ryanmccormickdev/bassbox/enclosure/renders/enclosure-details.png

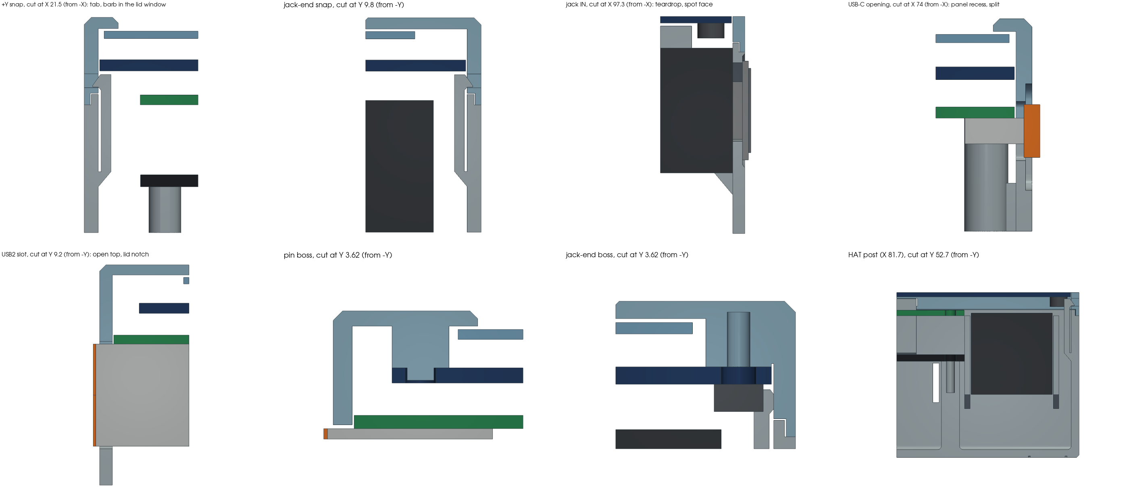
enclosure/renders/enclosure-details.png
