ryanmccormickdev/bassbox/enclosure/renders/section-x.png

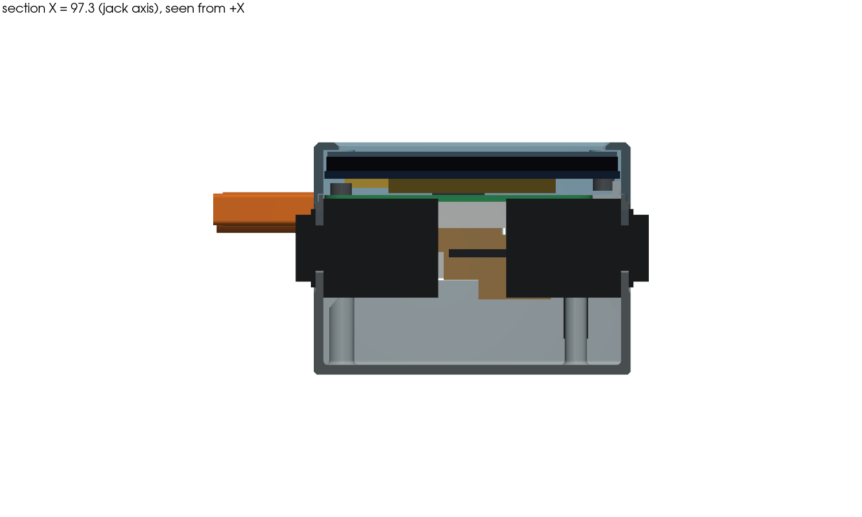
enclosure/renders/section-x.png
