ryanmccormickdev/bassbox/enclosure/renders/section-y.png

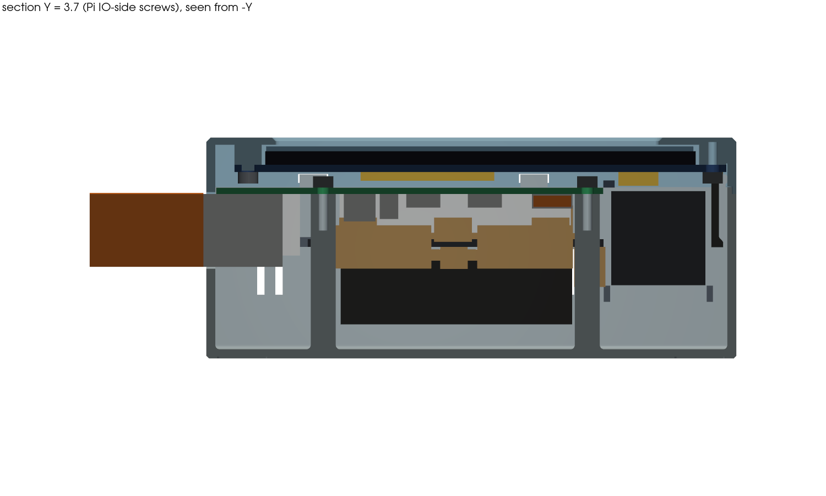
enclosure/renders/section-y.png
