ryanmccormickdev/bassbox/enclosure/renders/section-z.png

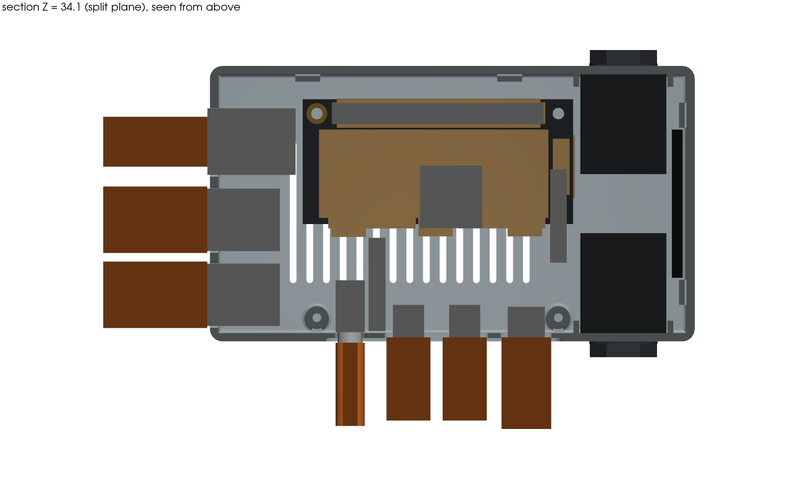
enclosure/renders/section-z.png
