ryanmccormickdev/bassbox/engine/tests/results/plots/drive_spectra_41.png

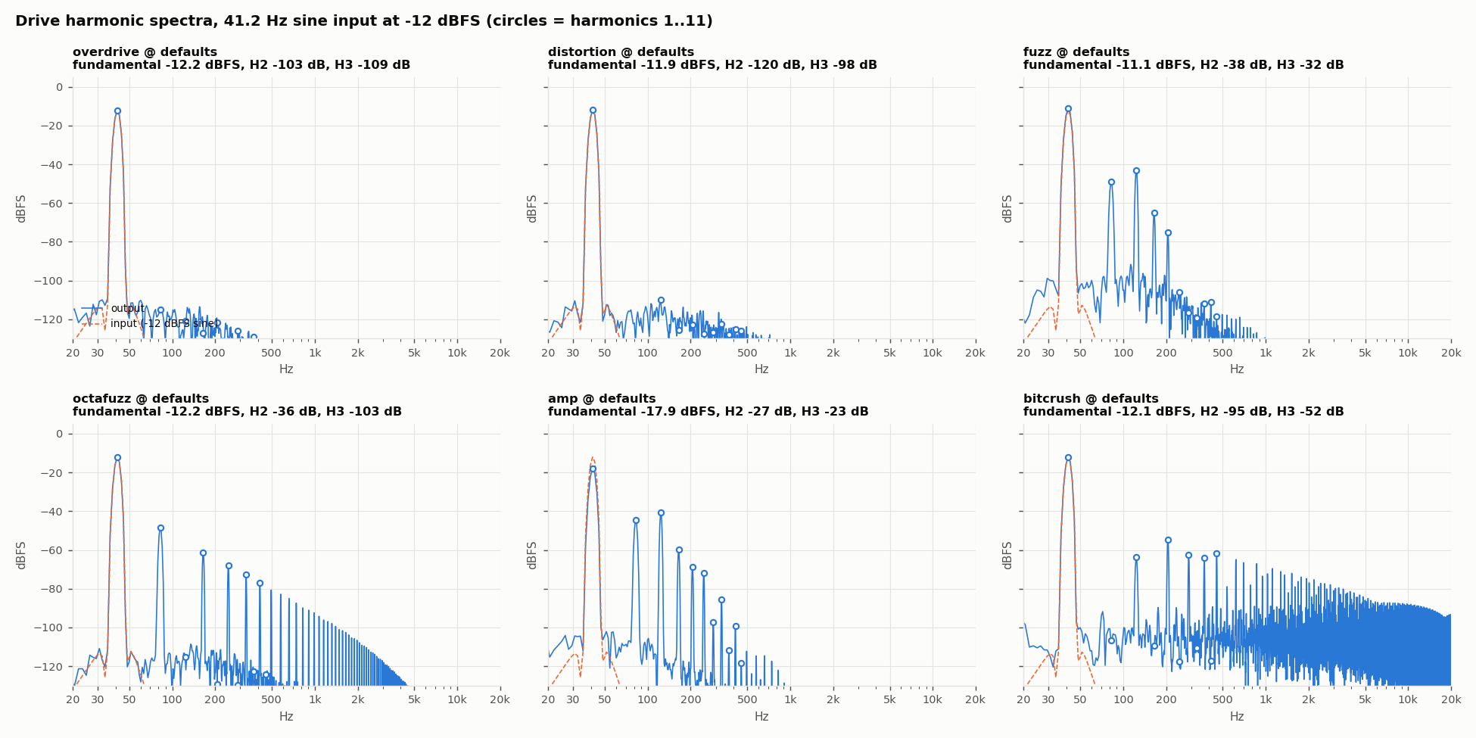
engine/tests/results/plots/drive_spectra_41.png
