ryanmccormickdev/bassbox/engine/tests/results/plots/drive_spectra_110.png

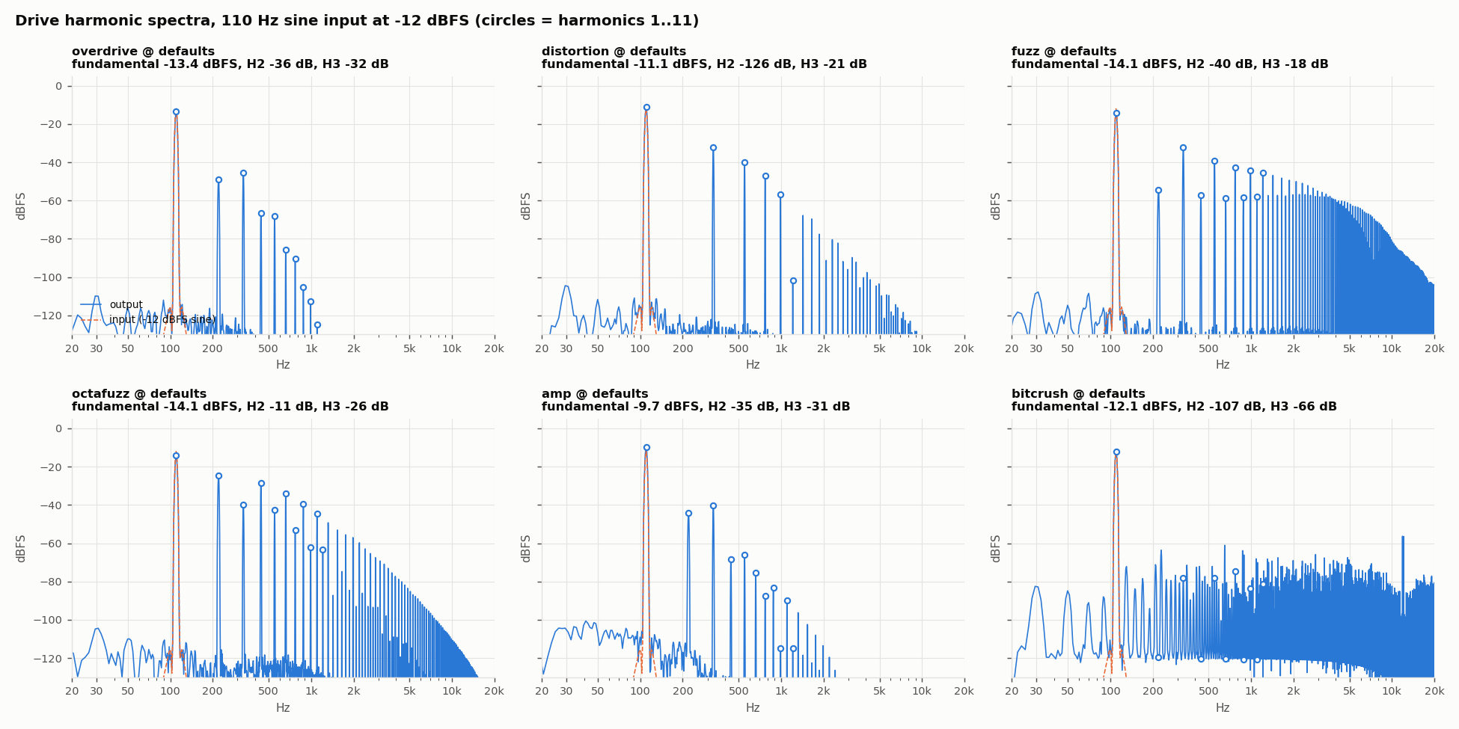
engine/tests/results/plots/drive_spectra_110.png
