ryanmccormickdev/bassbox/ui/mockups/contact_ABC.png

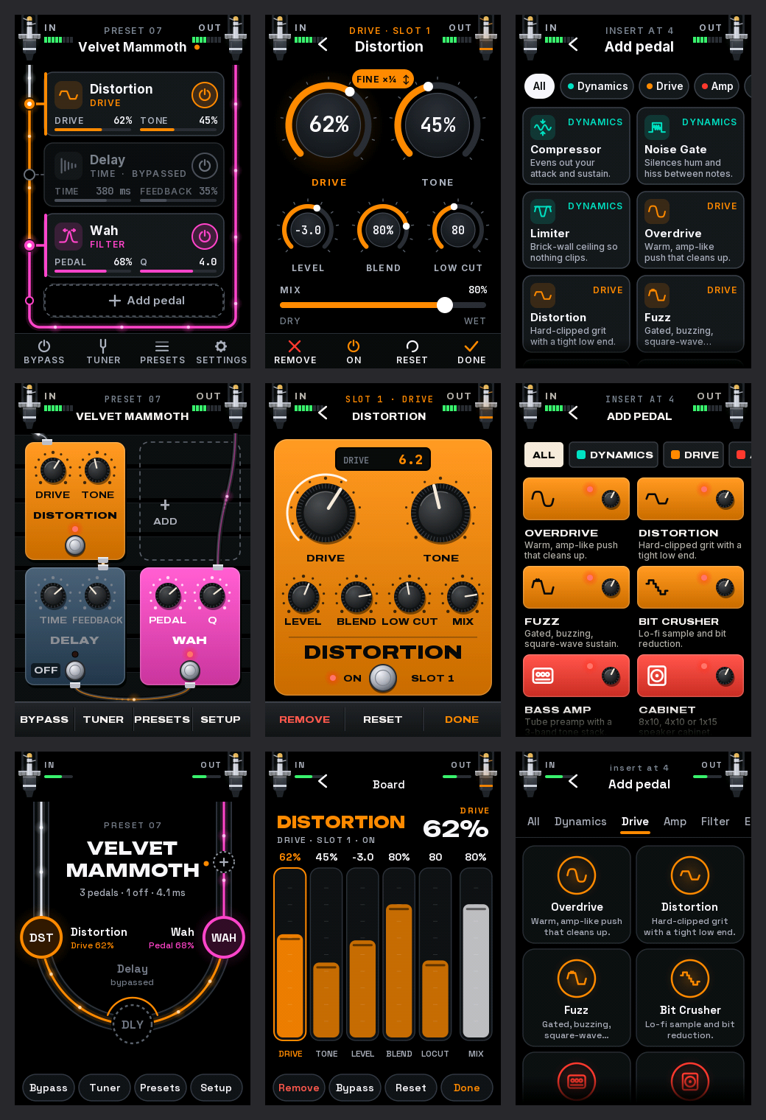
ui/mockups/contact_ABC.png
