ryanmccormickdev/bassbox/ui/mockups/dirA_board.png

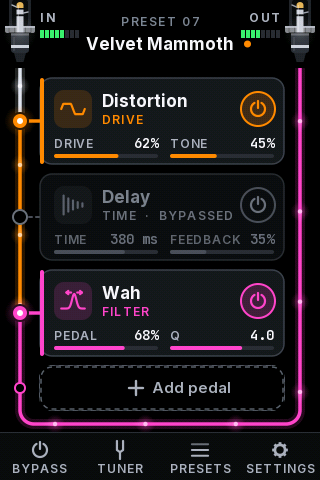
ui/mockups/dirA_board.png
