ryanmccormickdev/bassbox/ui/mockups/dirA_edit.png

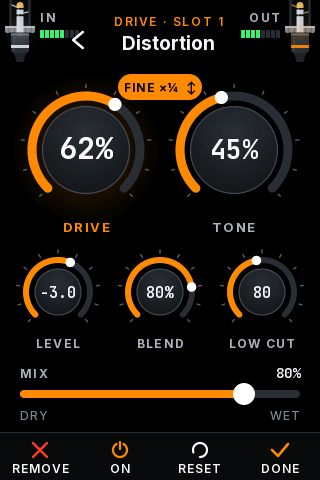
ui/mockups/dirA_edit.png
