ryanmccormickdev/bassbox/ui/mockups/dirA_library.png

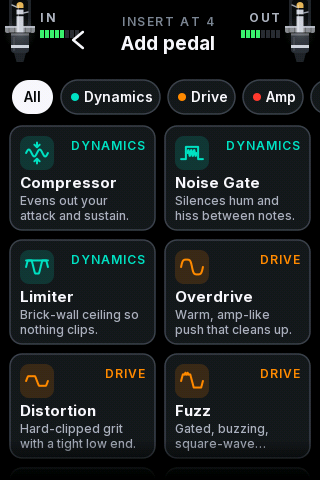
ui/mockups/dirA_library.png
