ryanmccormickdev/bassbox/ui/mockups/dirB_board.png

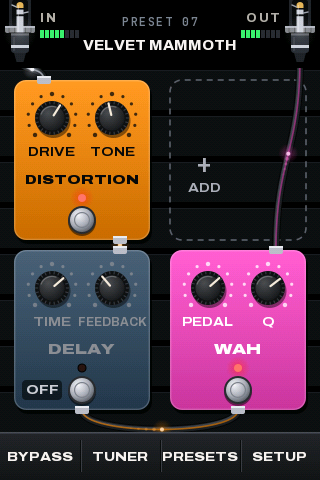
ui/mockups/dirB_board.png
