ryanmccormickdev/bassbox/ui/mockups/dirB_edit.png

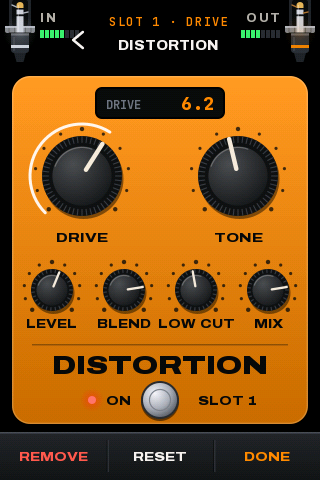
ui/mockups/dirB_edit.png
