ryanmccormickdev/bassbox/ui/mockups/dirB_library.png

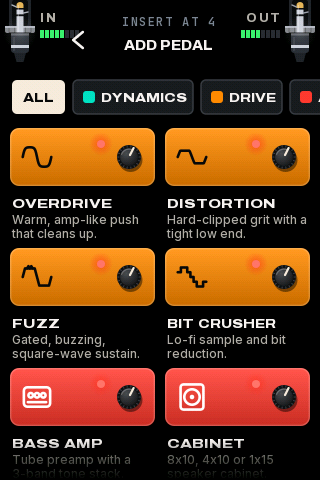
ui/mockups/dirB_library.png
