ryanmccormickdev/bassbox/ui/mockups/dirC_board.png

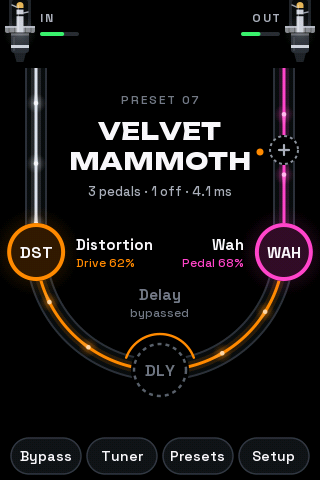
ui/mockups/dirC_board.png
