ryanmccormickdev/bassbox/ui/mockups/dirC_edit.png

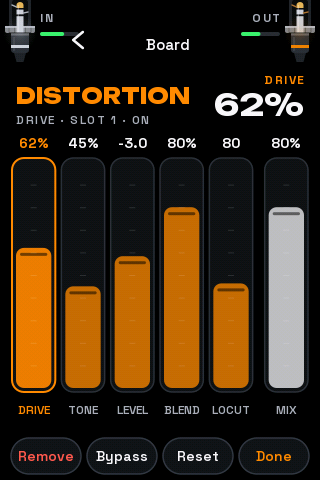
ui/mockups/dirC_edit.png
