ryanmccormickdev/bassbox/ui/mockups/dirC_library.png

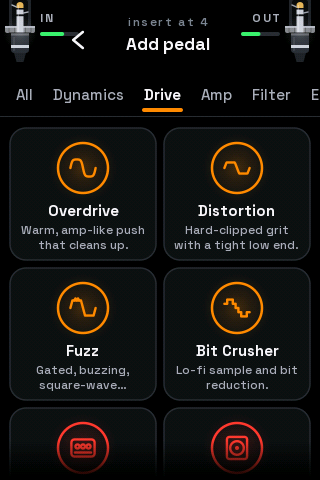
ui/mockups/dirC_library.png
