ryanmccormickdev/bassbox/ui/mockups/photo_dirA_board.jpg

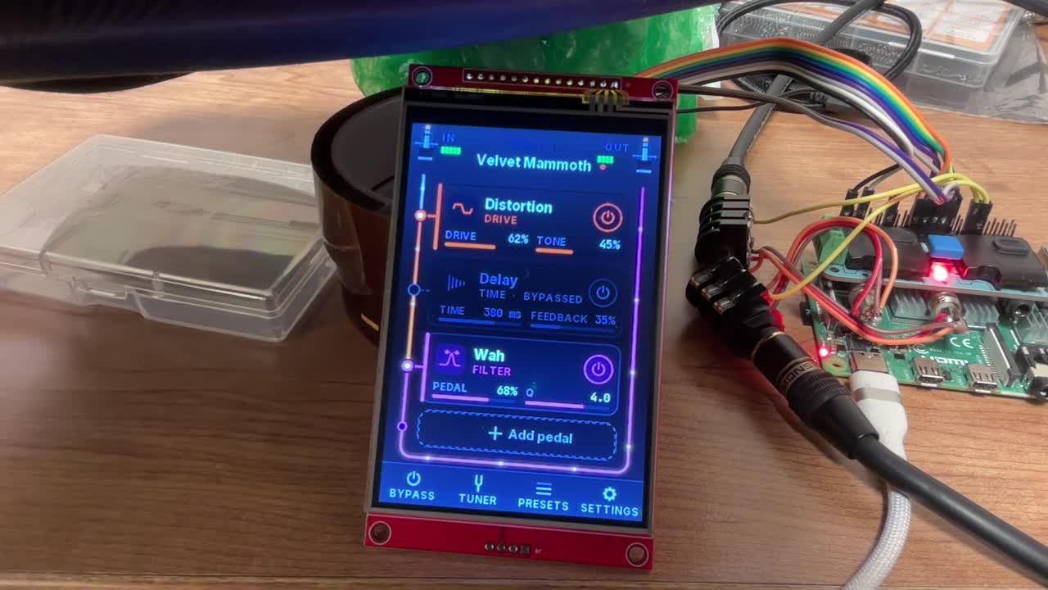
ui/mockups/photo_dirA_board.jpg
