ryanmccormickdev/bassbox/ui/mockups/photo_dirB_board.jpg

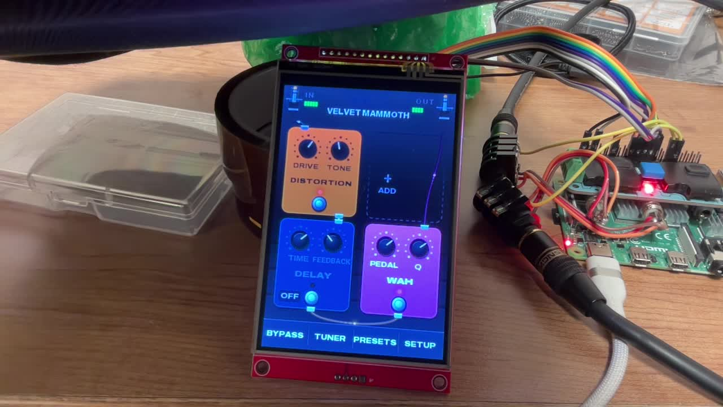
ui/mockups/photo_dirB_board.jpg
