ryanmccormickdev/bassbox/ui/shots/audiocheck.png

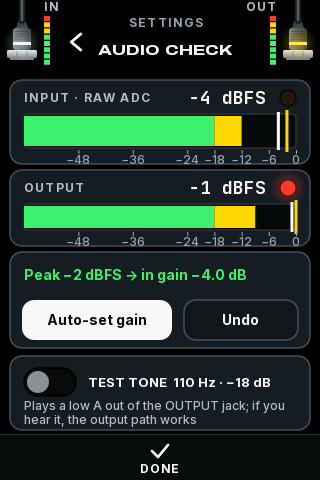
ui/shots/audiocheck.png
