ryanmccormickdev/bassbox/ui/shots/audiocheck_listen.png

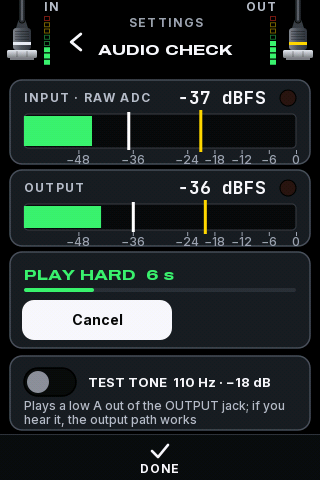
ui/shots/audiocheck_listen.png
