ryanmccormickdev/bassbox/ui/shots/audiocheck_pair.png

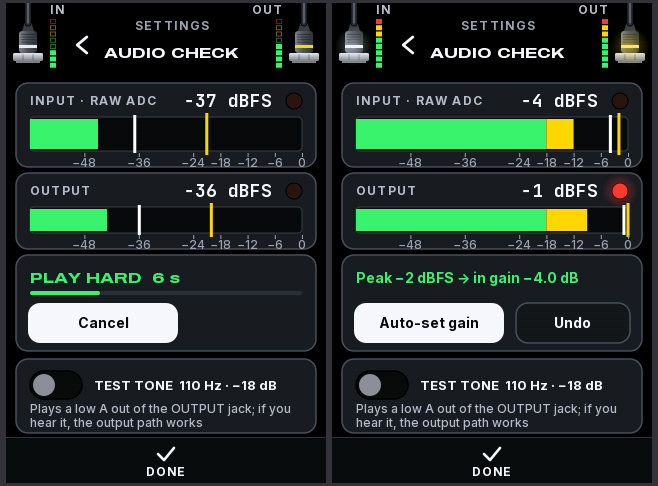
ui/shots/audiocheck_pair.png
