ryanmccormickdev/bassbox/ui/shots/audiocheck_pi.png

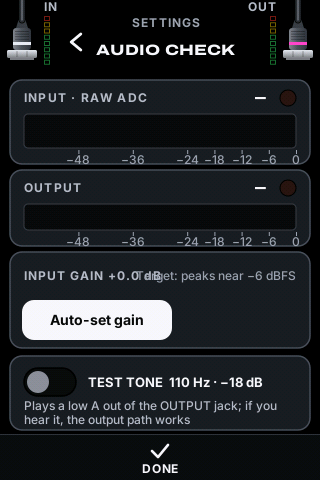
ui/shots/audiocheck_pi.png
