ryanmccormickdev/bassbox/ui/shots/board_3.png

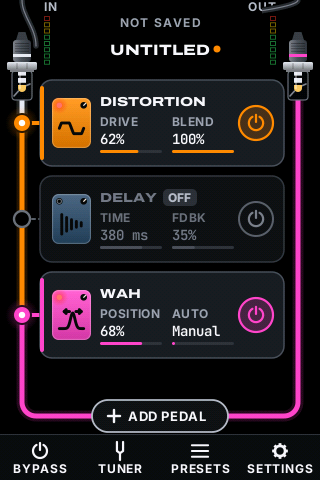
ui/shots/board_3.png
