ryanmccormickdev/bassbox/ui/shots/board_7.png

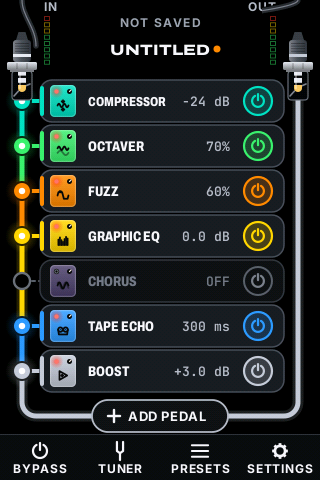
ui/shots/board_7.png
