ryanmccormickdev/bassbox/ui/shots/board_bypass.png

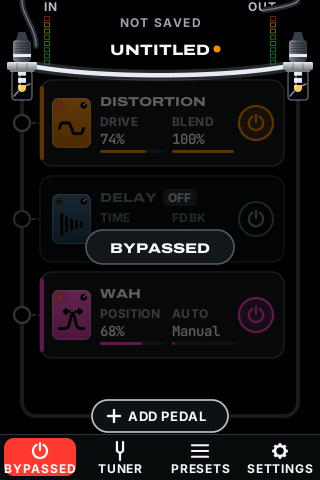
ui/shots/board_bypass.png
