ryanmccormickdev/bassbox/ui/shots/board_in_unplugged.png

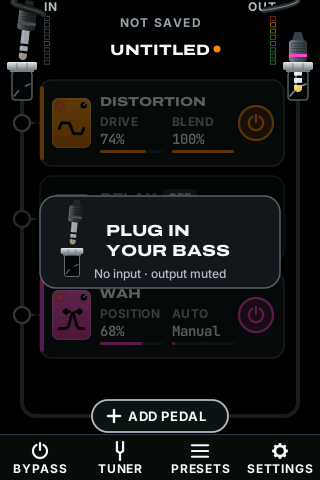
ui/shots/board_in_unplugged.png
