ryanmccormickdev/bassbox/ui/shots/contact.png

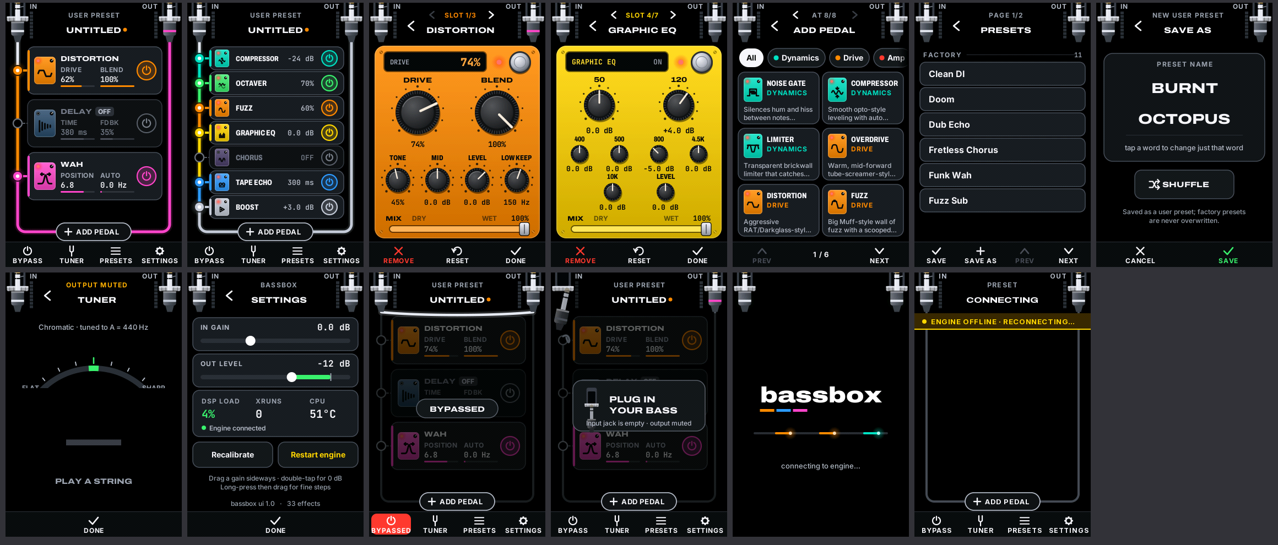
ui/shots/contact.png
