ryanmccormickdev/bassbox/ui/shots/edit_distortion.png

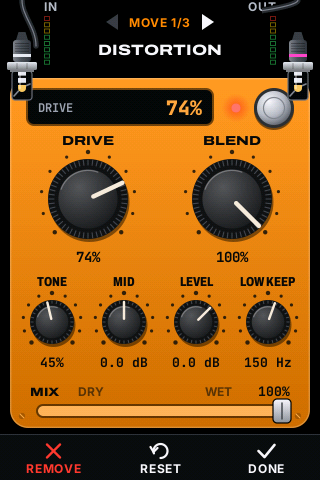
ui/shots/edit_distortion.png
