ryanmccormickdev/bassbox/ui/shots/edit_geq7.png

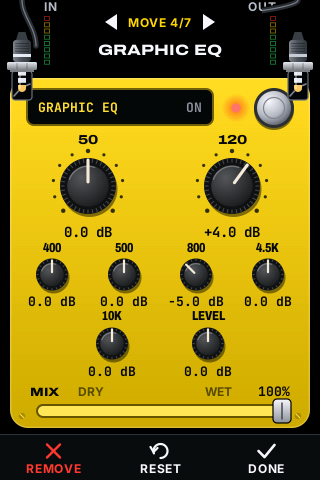
ui/shots/edit_geq7.png
