ryanmccormickdev/bassbox/ui/shots/edit_looper.png

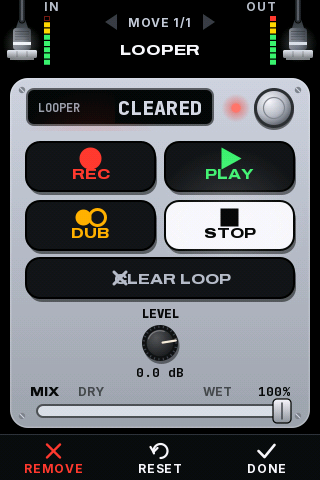
ui/shots/edit_looper.png
