ryanmccormickdev/bassbox/ui/shots/edit_nam.png

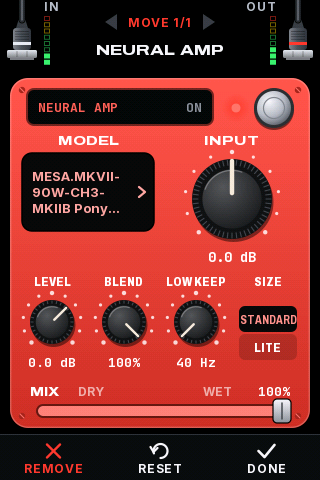
ui/shots/edit_nam.png
