ryanmccormickdev/bassbox/ui/shots/jack_anim.png

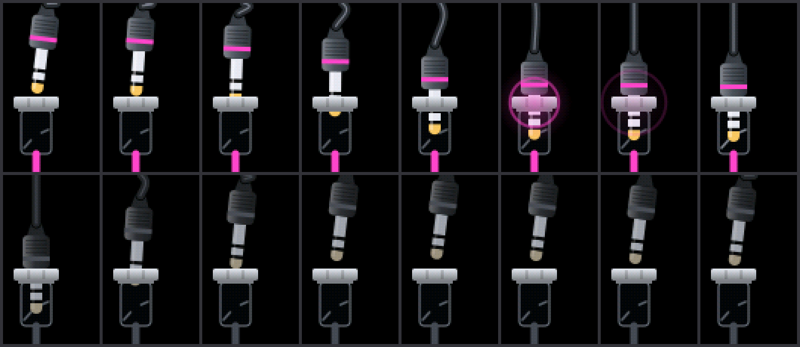
ui/shots/jack_anim.png
