ryanmccormickdev/bassbox/ui/shots/library.png

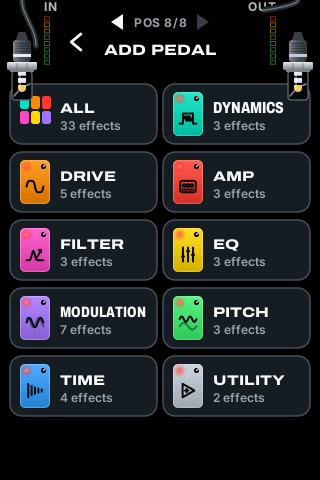
ui/shots/library.png
