ryanmccormickdev/bassbox/ui/shots/library_drive.png

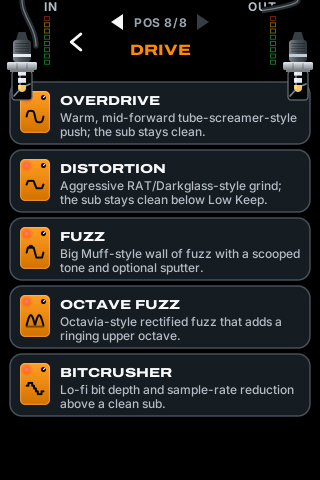
ui/shots/library_drive.png
