ryanmccormickdev/bassbox/ui/shots/nam_picker.png

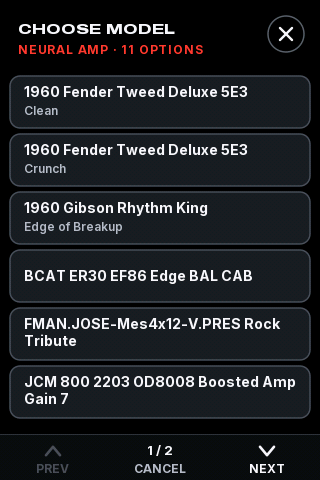
ui/shots/nam_picker.png
