ryanmccormickdev/bassbox/ui/shots/nam_presets.png

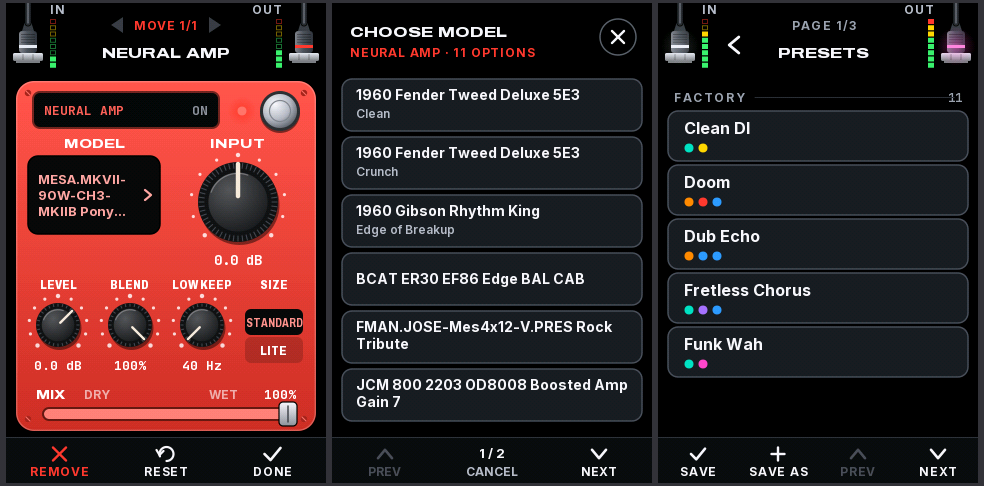
ui/shots/nam_presets.png
