ryanmccormickdev/bassbox/ui/shots/phaseC.png

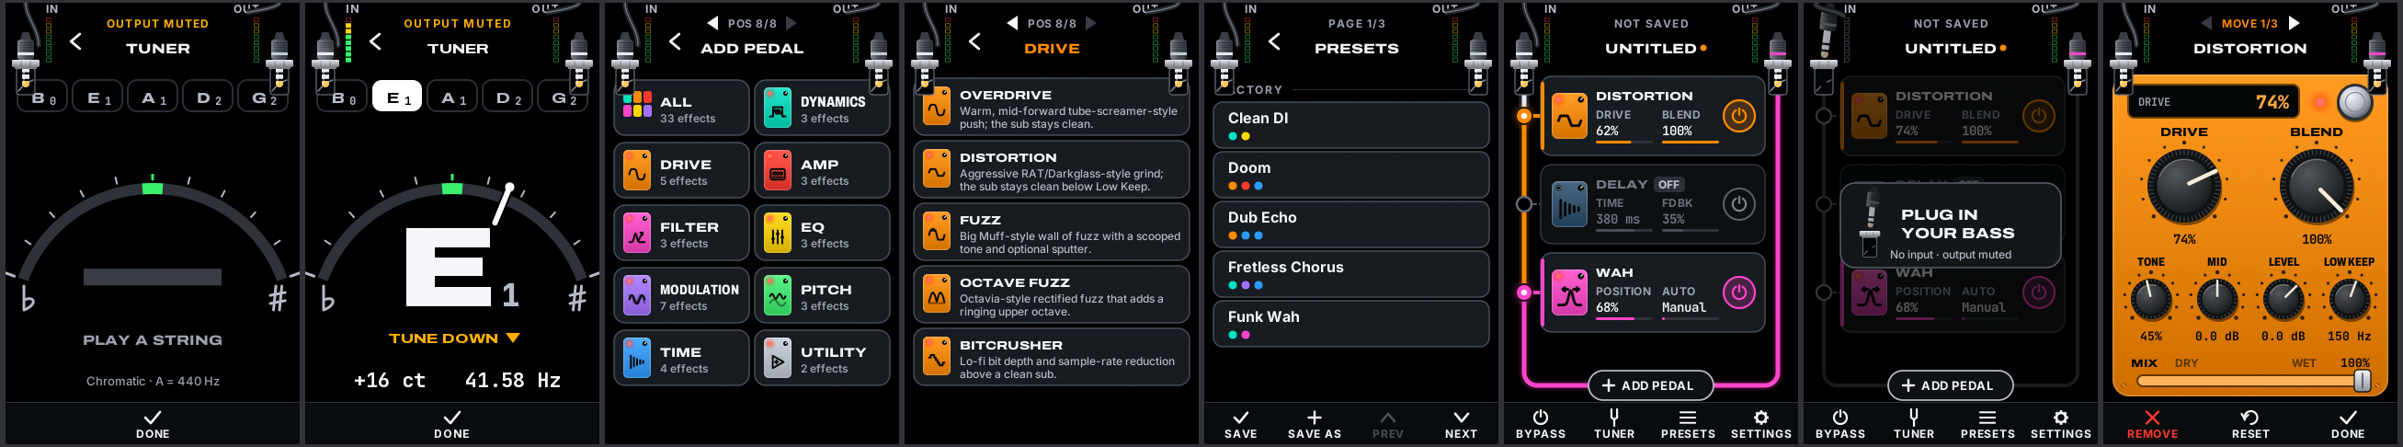
ui/shots/phaseC.png
