ryanmccormickdev/bassbox/ui/shots/presets.png

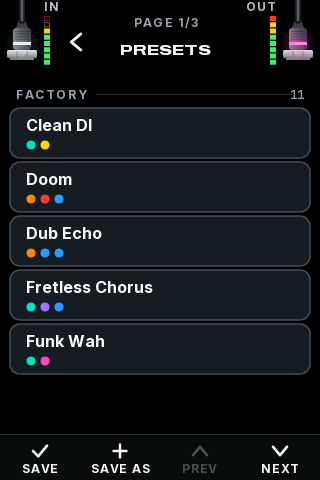
ui/shots/presets.png
