ryanmccormickdev/bassbox/ui/shots/reconnecting.png

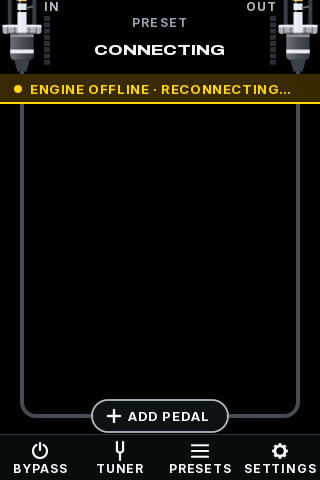
ui/shots/reconnecting.png
