ryanmccormickdev/bassbox/ui/shots/saveas.png

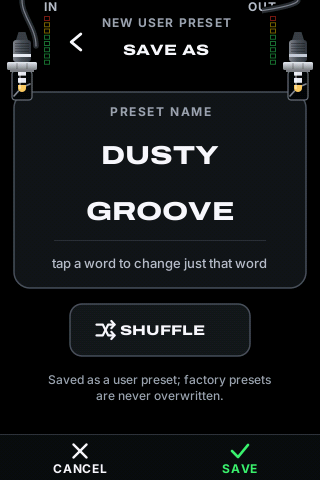
ui/shots/saveas.png
