ryanmccormickdev/bassbox/ui/shots/settings.png

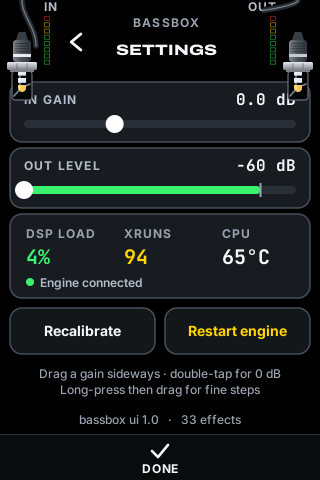
ui/shots/settings.png
