ryanmccormickdev/bassbox/ui/shots/sweep_boards.png

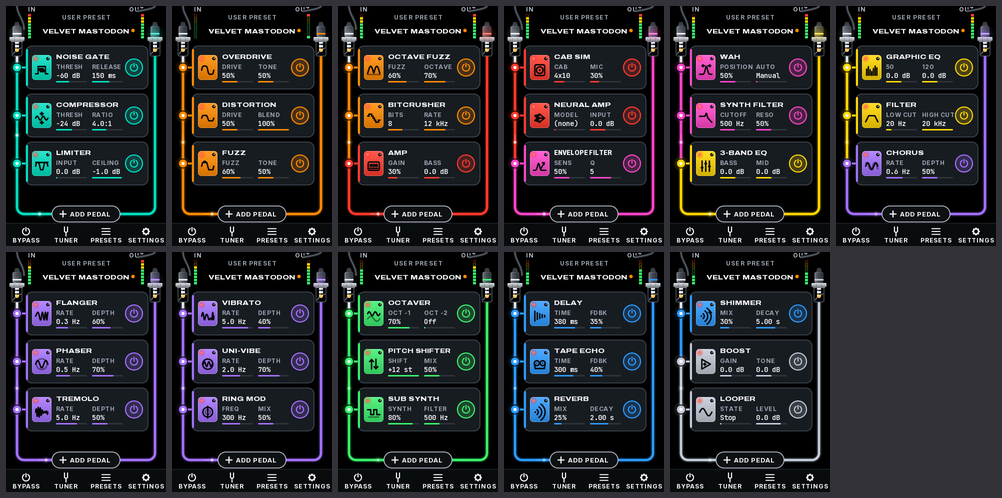
ui/shots/sweep_boards.png
