ryanmccormickdev/bassbox/ui/shots/sweep_faces.png

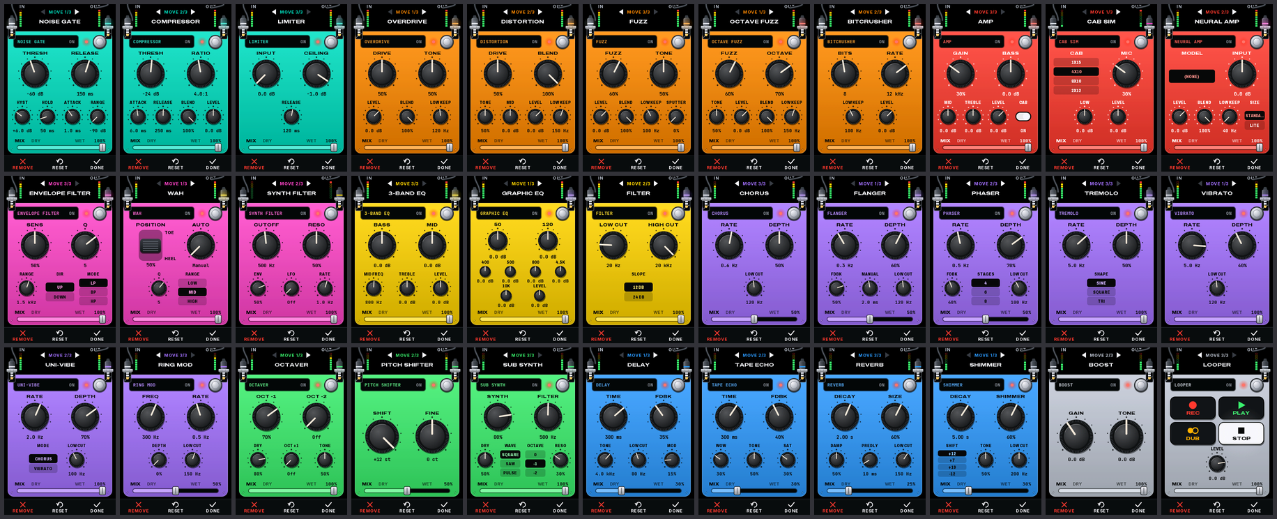
ui/shots/sweep_faces.png
