ryanmccormickdev/bassbox/ui/shots/tuner.png

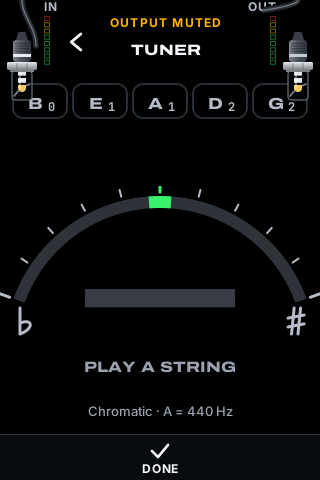
ui/shots/tuner.png
