ryanmccormickdev/bassbox/ui/shots/tuner_reading_mock.png

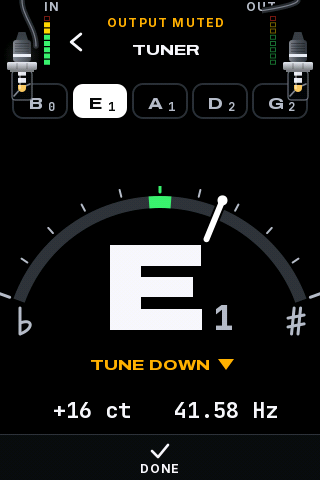
ui/shots/tuner_reading_mock.png
