ryanmccormickdev/bassbox/enclosure/renders/components-keepouts.png

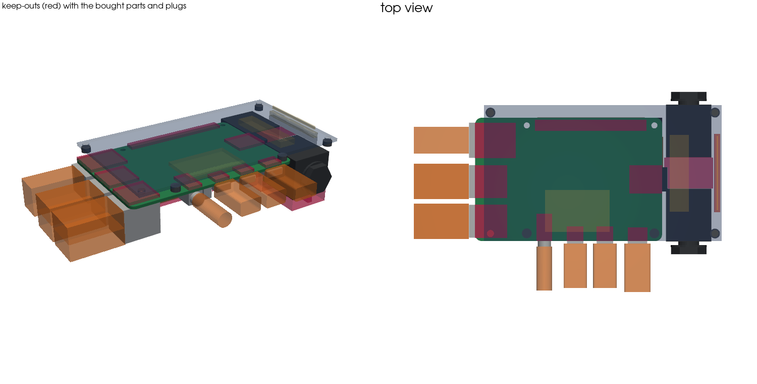
enclosure/renders/components-keepouts.png
