ryanmccormickdev/bassbox/enclosure/exports/step/pedal-assembly.step

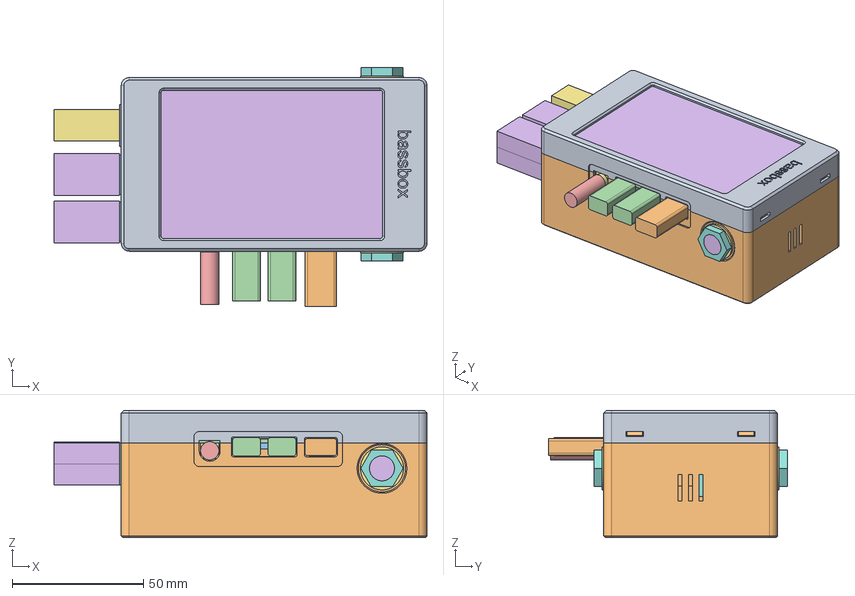
[picture p51: CAD file, 2026-11-01]
enclosure/exports/step/pedal-assembly.step
142.0 x 90.9 x 48.5 mm
lid
base
spacer
lcd.pcb
lcd.panel
lcd.glass
lcd.header
lcd.dupont
lcd.tails
lcd.smd
lcd.sd
pi.pcb
pi.usb_c
pi.hdmi0
pi.hdmi1
pi.audio
pi.usb2
pi.usb3
pi.eth
pi.header
pi.soc
pi.csi
pi.dsi
pi.sd_card
hat.pcb
hat.terminal
hat.terminal_tails
hat.speaker_a
hat.speaker_b
hat.jack35_a
hat.jack35_b
hat.jack35_c
hat.button
hat.header_plastic
hat.pins
hat.female
hat.bottom_smd
hat.bottom_pins
hat.smd_hole_a
hat.smd_hole_b
hat.dupont
jack_in.body
jack_in.bushing
jack_in.washer
jack_in.nut
jack_out.body
jack_out.bushing
jack_out.washer
jack_out.nut
screw.pi_io1
screw.pi_io2
screw.lcd1
screw.lcd2
screw.lcd3
plug.usb_c.overmold
plug.usb_c.metal
plug.hdmi0.overmold
plug.hdmi1.overmold
plug.audio.overmold
plug.usb2a.overmold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
