ryanmccormickdev/bassbox/enclosure/exports/3mf/pedal-plate.3mf

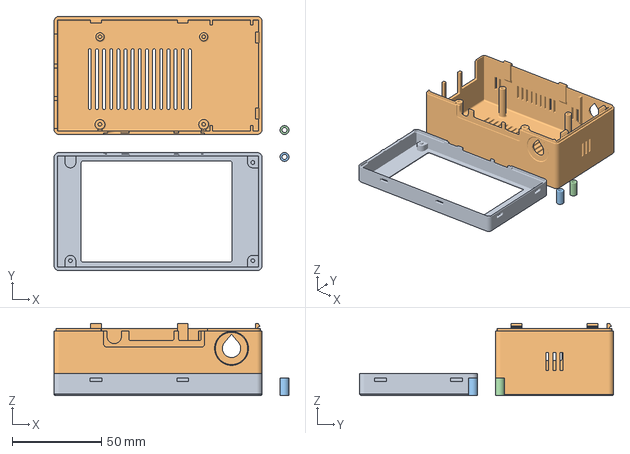
[picture p52: CAD file, 2026-11-01]
enclosure/exports/3mf/pedal-plate.3mf
131.4 x 142.3 x 40.4 mm
