ryanmccormickdev/bassbox/enclosure/exports/stl/spacer.stl

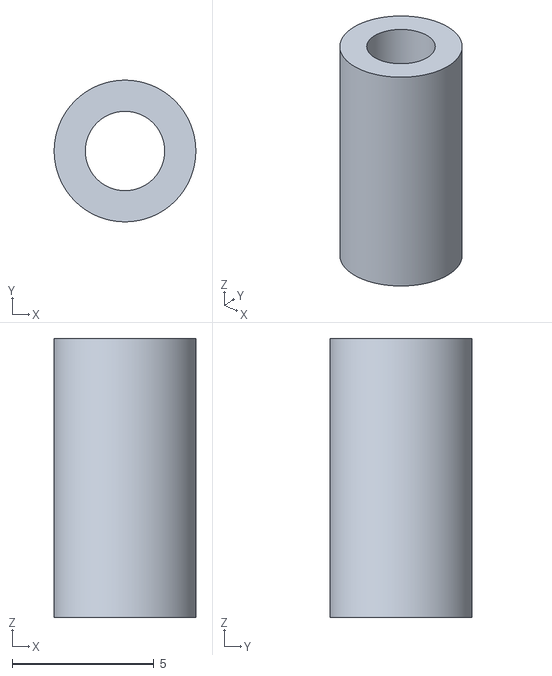
[picture p53: CAD file, 2026-11-01]
enclosure/exports/stl/spacer.stl
5.00 x 5.00 x 9.85
