ryanmccormickdev/bassbox/enclosure/print-profiles/prusa-mk39s/pedal-base-mk39s-clear-petg.3mf

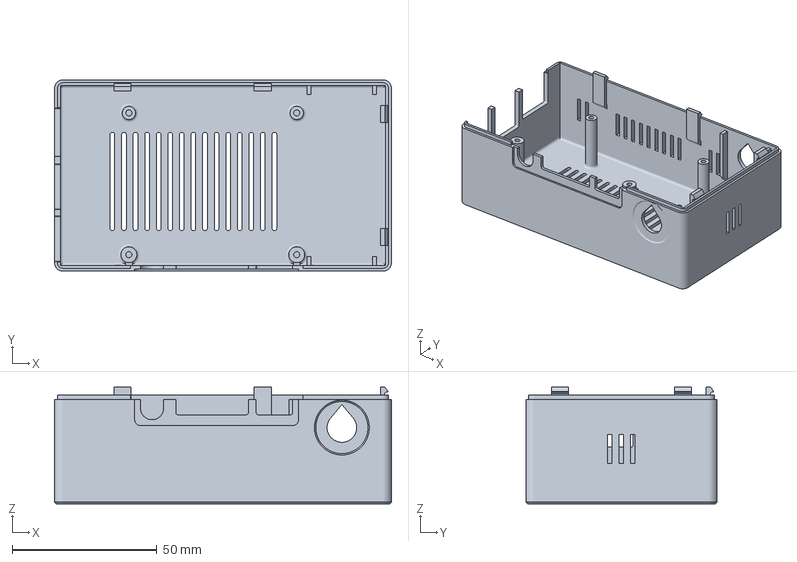
[picture p54: CAD file, 2026-11-01]
enclosure/print-profiles/prusa-mk39s/pedal-base-mk39s-clear-petg.3mf
116.4 x 66.1 x 40.4 mm
