ryanmccormickdev/bassbox/enclosure/exports/step/enclosure-installed.step

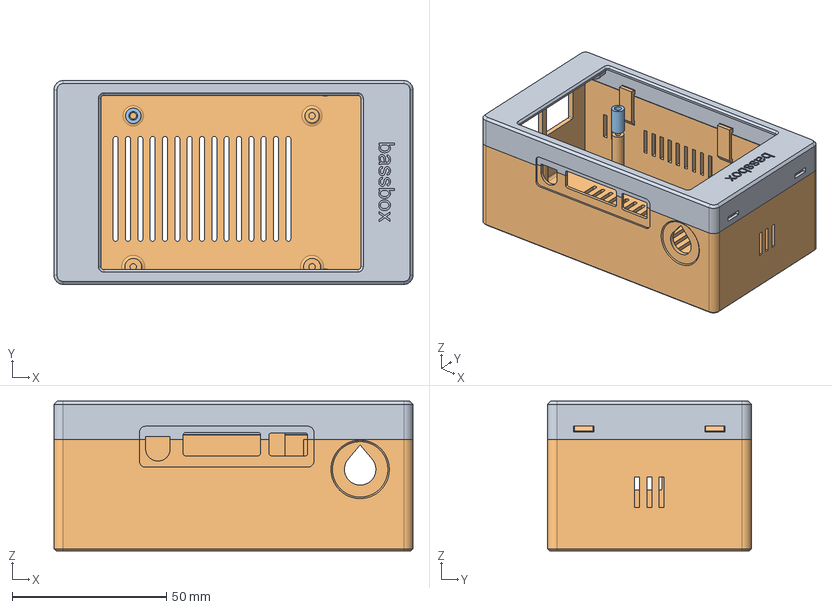
[picture p55: CAD file, 2026-11-01]
enclosure/exports/step/enclosure-installed.step
116.4 x 66.1 x 48.5 mm
lid
base
spacer
