ryanmccormickdev/bassbox/enclosure/exports/stl/lid.stl

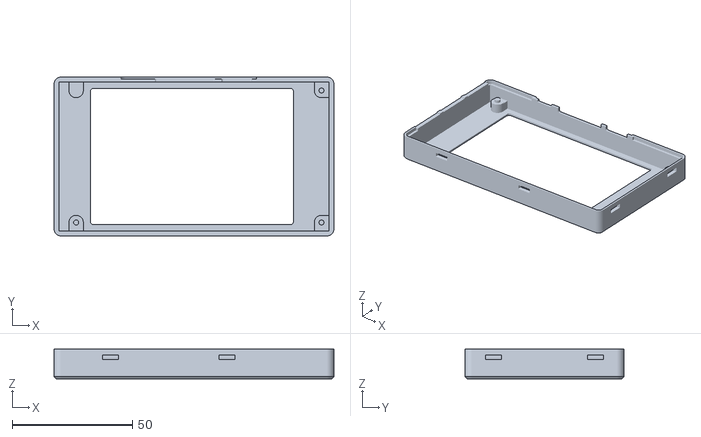
[picture p56: CAD file, 2026-11-01]
enclosure/exports/stl/lid.stl
116.4 x 66.1 x 12.4
