ryanmccormickdev/bassbox/(list of files, cad)

Other CAD files:
enclosure/print-profiles/prusa-xl/pedal-plate-xl-clear-petg.3mf
enclosure/exports/stl/base.stl
