ryanmccormickdev/bassbox/enclosure/renders/assembly-exploded.png

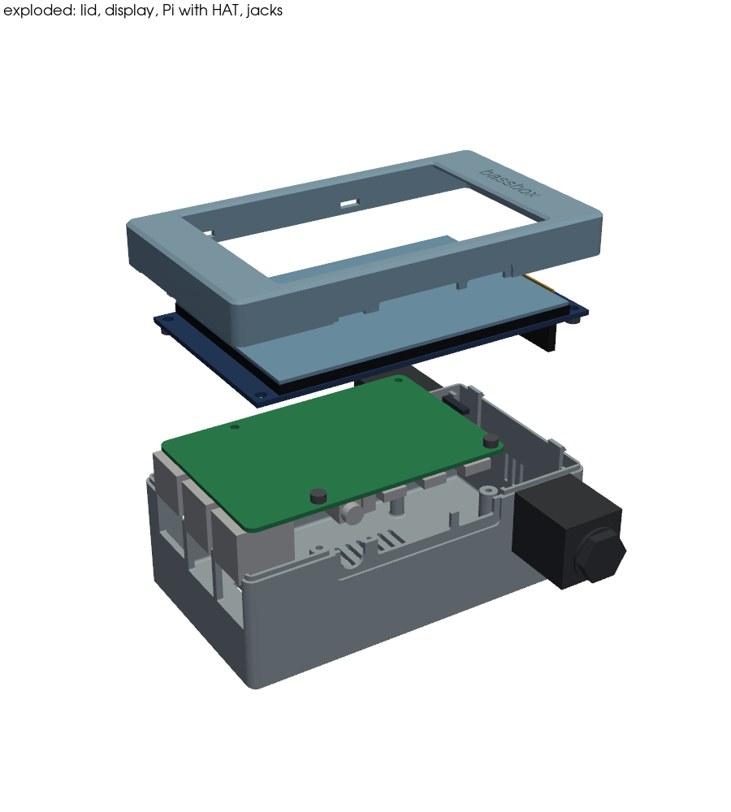
enclosure/renders/assembly-exploded.png
