ryanmccormickdev/bassbox/enclosure/renders/assembly-iso.png

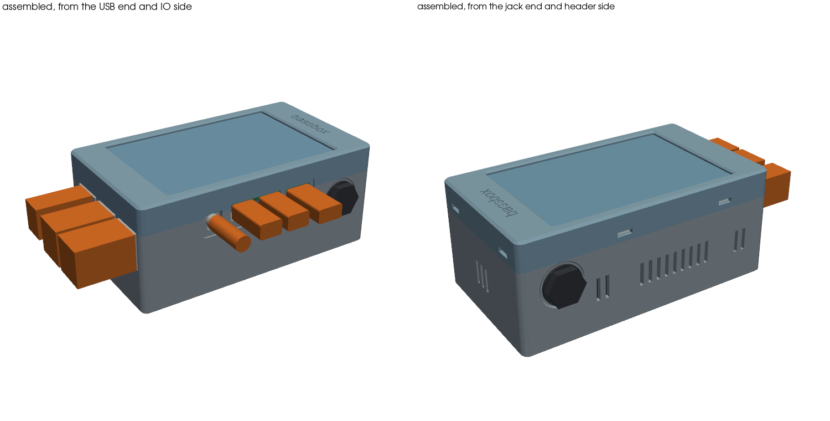
enclosure/renders/assembly-iso.png
