ryanmccormickdev/bassbox/enclosure/renders/assembly-translucent.png

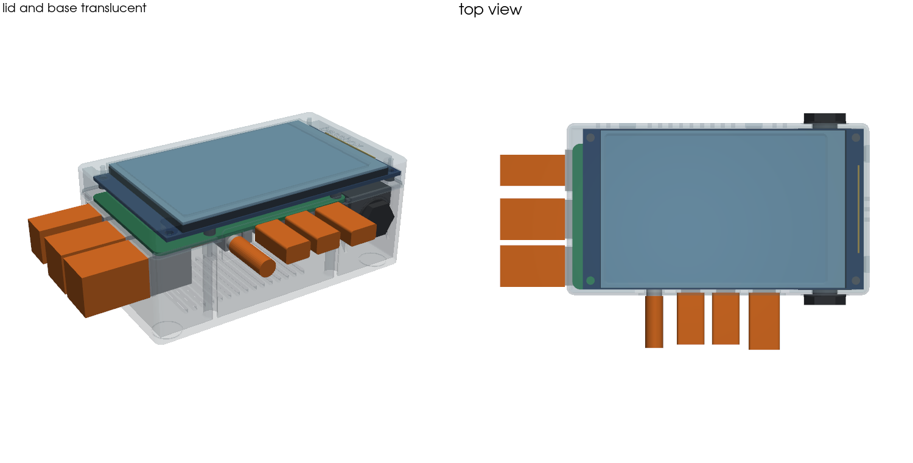
enclosure/renders/assembly-translucent.png
