ryanmccormickdev/bassbox/enclosure/renders/base-installed.png

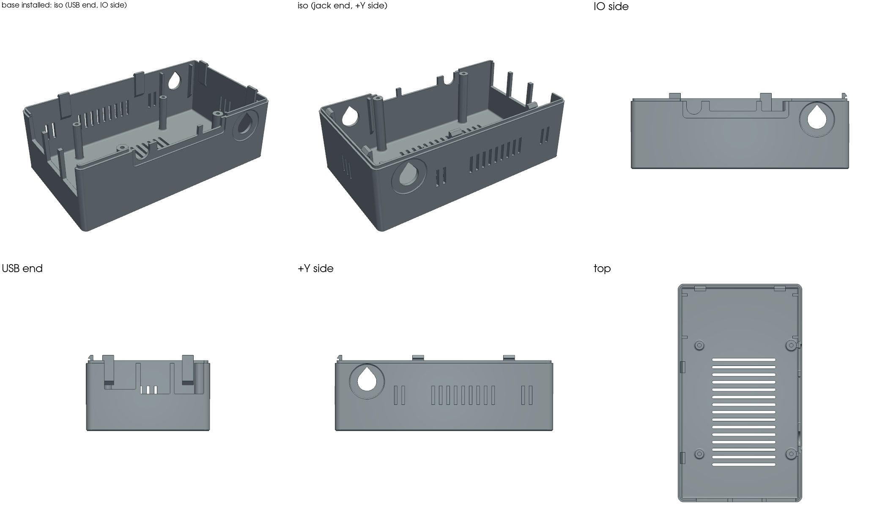
enclosure/renders/base-installed.png
