ryanmccormickdev/bassbox/enclosure/renders/base-print.png

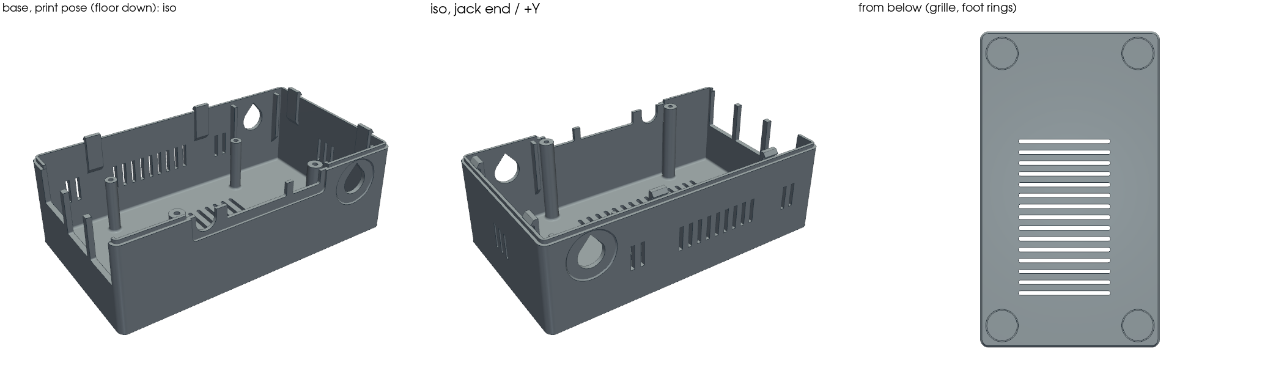
enclosure/renders/base-print.png
