ryanmccormickdev/bassbox/enclosure/renders/enclosure-installed.png

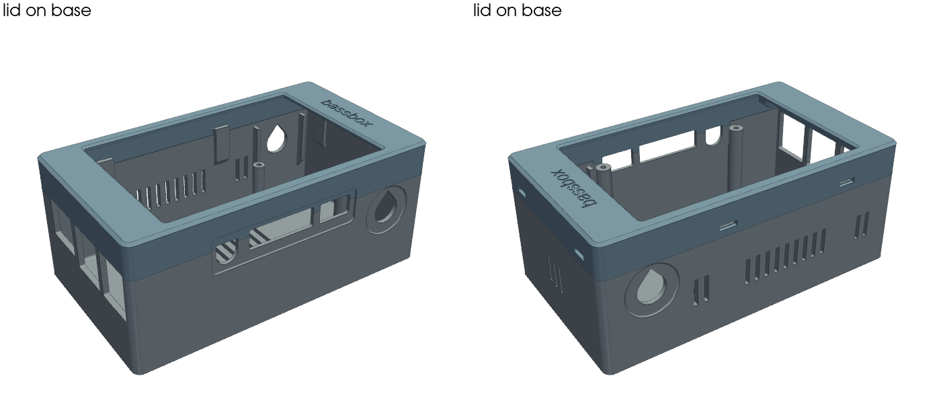
enclosure/renders/enclosure-installed.png
