ryanmccormickdev/bassbox/enclosure/renders/lid-installed.png

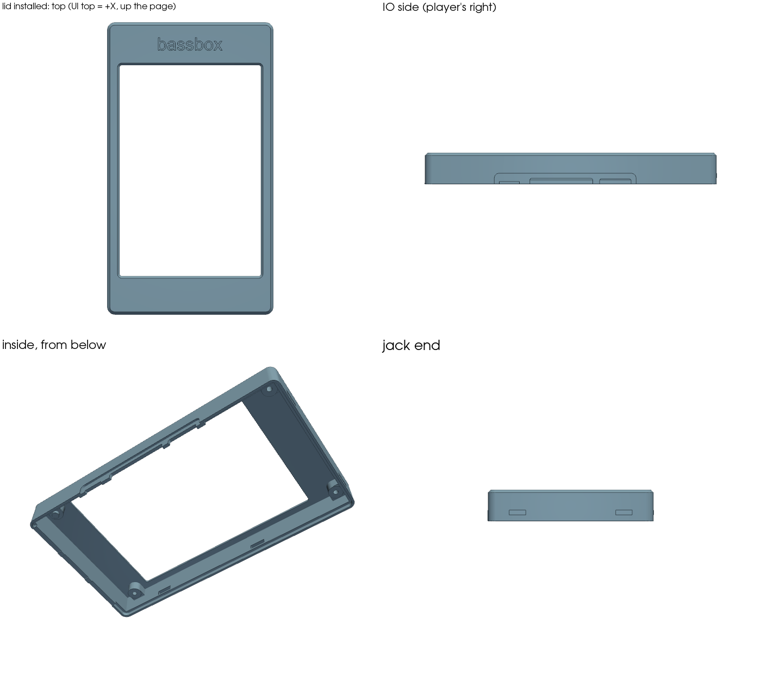
enclosure/renders/lid-installed.png
