ryanmccormickdev/bassbox/enclosure/renders/lid-print.png

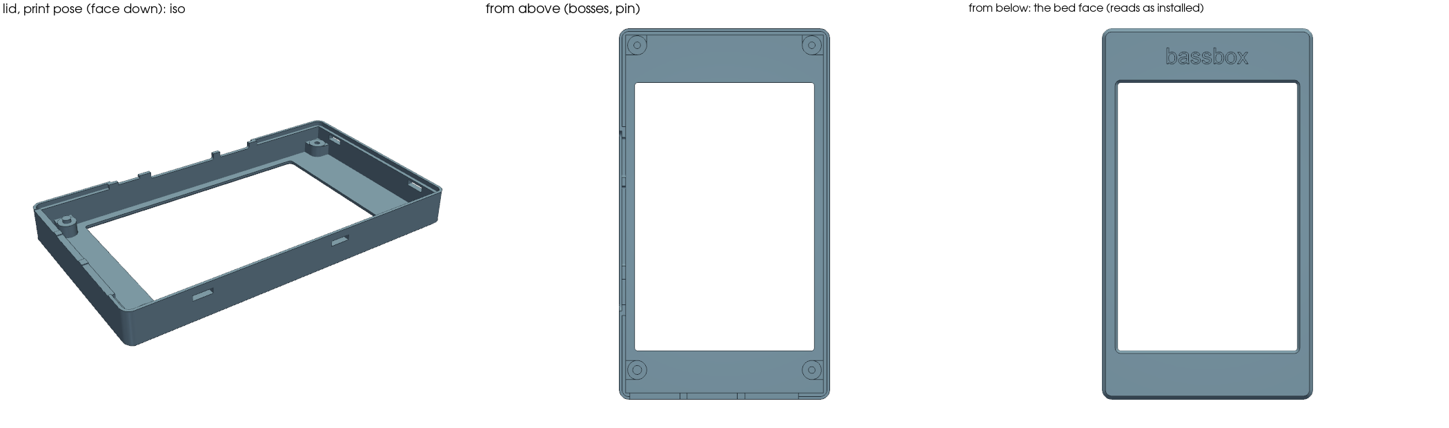
enclosure/renders/lid-print.png
