ryanmccormickdev/bassbox/enclosure/renders/spacer-print.png

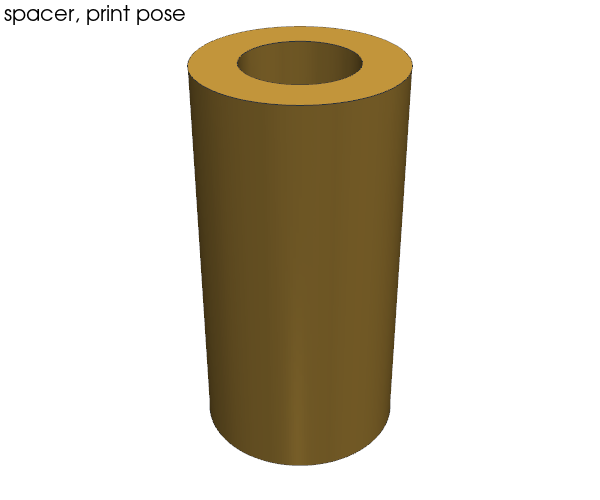
enclosure/renders/spacer-print.png
