ryanmccormickdev/bassbox/engine/tests/results/cpu.md

# CPU per 64-frame block on bassbox

Mean and p99 microseconds per 64-frame block (1333 us of audio); % = mean / period, i.e. share of one core. Worst of defaults and all-max settings. FTZ on.

| id | mean us (defaults) | mean us (all-max) | p99 us | % of core |
|---|---|---|---|---|
| gate | 1.94 | 1.85 | 1.89 | 0.15% |
| comp | 5.35 | 5.00 | 5.68 | 0.40% |
| limiter | 11.91 | 12.54 | 13.04 | 0.94% |
| overdrive | 16.84 | 15.45 | 16.85 | 1.26% |
| distortion | 14.10 | 14.03 | 14.33 | 1.06% |
| fuzz | 18.26 | 22.58 | 23.33 | 1.69% |
| octafuzz | 16.41 | 16.33 | 16.50 | 1.23% |
| bitcrush | 2.91 | 3.05 | 3.07 | 0.23% |
| amp | 29.98 | 26.56 | 30.76 | 2.25% |
| cab | 4.02 | 4.02 | 4.04 | 0.30% |
| nam | 275.62 | 132.38 | 359.31 | 20.67% |
| env_filter | 11.51 | 11.48 | 11.52 | 0.86% |
| wah | 8.14 | 8.16 | 8.20 | 0.61% |
| synth_filter | 10.78 | 10.78 | 10.83 | 0.81% |
| eq3 | 1.45 | 1.45 | 1.48 | 0.11% |
| geq7 | 0.90 | 3.11 | 3.11 | 0.23% |
| cut | 2.87 | 2.88 | 2.89 | 0.22% |
| chorus | 9.58 | 9.58 | 9.59 | 0.72% |
| flanger | 7.66 | 7.05 | 7.67 | 0.57% |
| phaser | 12.99 | 12.29 | 13.06 | 0.97% |
| tremolo | 2.50 | 2.26 | 2.50 | 0.19% |
| vibrato | 5.07 | 5.08 | 5.09 | 0.38% |
| univibe | 11.06 | 10.35 | 10.37 | 0.83% |
| ringmod | 8.19 | 9.16 | 8.31 | 0.69% |
| octaver | 5.81 | 5.81 | 5.96 | 0.44% |
| pitch | 6.51 | 6.55 | 7.61 | 0.49% |
| subsynth | 16.86 | 16.92 | 17.70 | 1.27% |
| delay | 7.07 | 7.16 | 7.37 | 0.54% |
| tape | 9.27 | 9.28 | 9.54 | 0.70% |
| reverb | 23.44 | 25.02 | 27.76 | 1.88% |
| shimmer | 27.11 | 27.96 | 30.18 | 2.10% |
| boost | 1.10 | 1.09 | 1.11 | 0.08% |
| looper | 0.42 | 0.42 | 0.43 | 0.03% |
