ryanmccormickdev/bassbox/engine/tests/results/presets.md

# Factory presets through the riff (host semantics: enabled, mix, master gains)

| preset | chain | RMS out - in (dB) | peak dBFS | tail after riff (dBFS peak, last 0.5 s of 3 s) | problems |
|---|---|---|---|---|---|
| Clean DI | comp > eq3 | +0.2 | -3.4 | -240 | - |
| Doom | fuzz > amp > reverb | +0.3 | -9.2 | -85 | - |
| Dub Echo | distortion > tape > reverb | +0.3 | -6.6 | -78 | - |
| Fretless Chorus | comp > chorus > reverb | +0.2 | -2.9 | -158 | - |
| Funk Wah | comp > env_filter | -0.1 | -0.6 | -240 | - |
| Fuzz Sub | octaver > fuzz | +0.2 | -7.9 | -240 | - |
| Grit | comp > overdrive > cab | +0.1 | -7.0 | -240 | - |
| Modern Grind | comp > distortion > geq7 > cab | +0.0 | -6.3 | -240 | - |
| Motown | comp > amp > cut | +0.1 | -6.1 | -240 | - |
| Night Drive | distortion > delay > wah | -0.1 | -6.6 | -120 | - |
| Synth Bass | subsynth > synth_filter | -1.2 | -2.0 | -240 | - |
