ryanmccormickdev/bassbox/engine/tests/results/plots/amp_filters_defaults.png

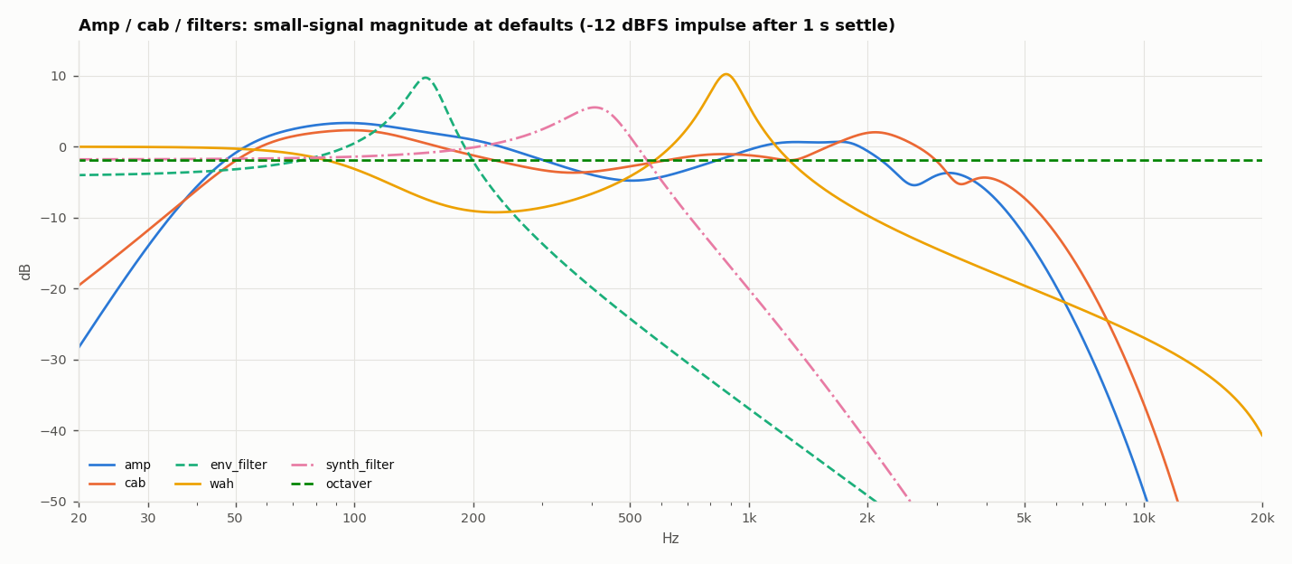
engine/tests/results/plots/amp_filters_defaults.png
