ryanmccormickdev/bassbox/engine/tests/results/plots/cab_responses.png

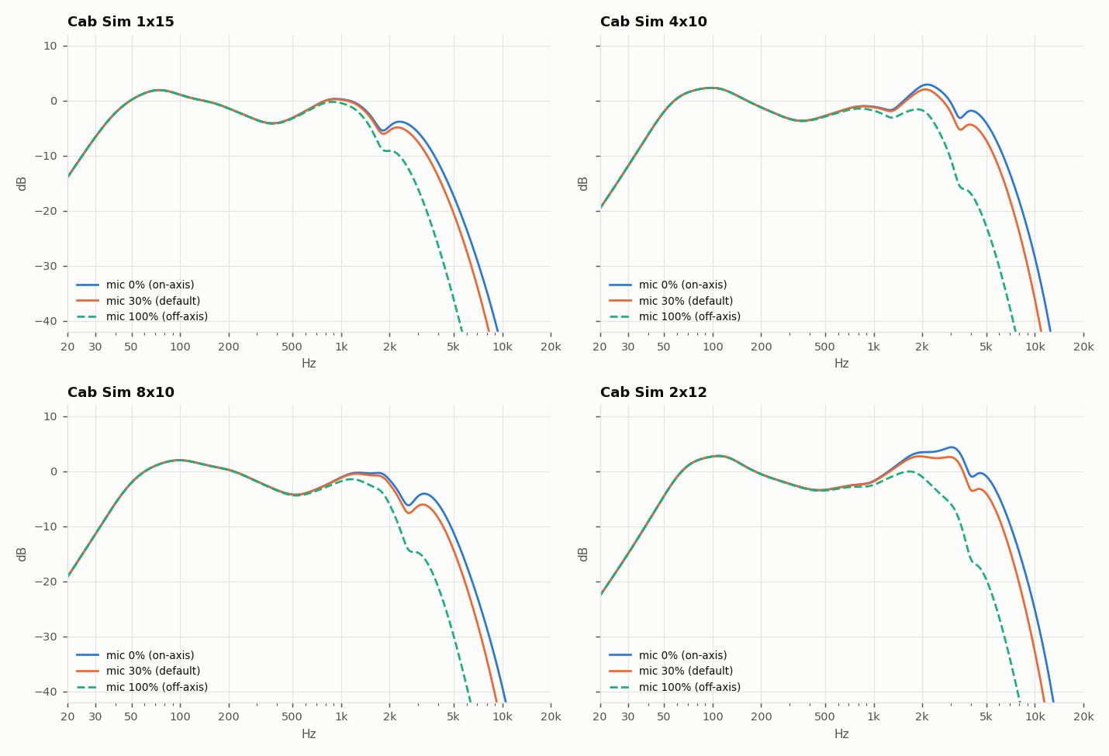
engine/tests/results/plots/cab_responses.png
