ryanmccormickdev/bassbox/engine/tests/results/plots/drive_aliasing.png

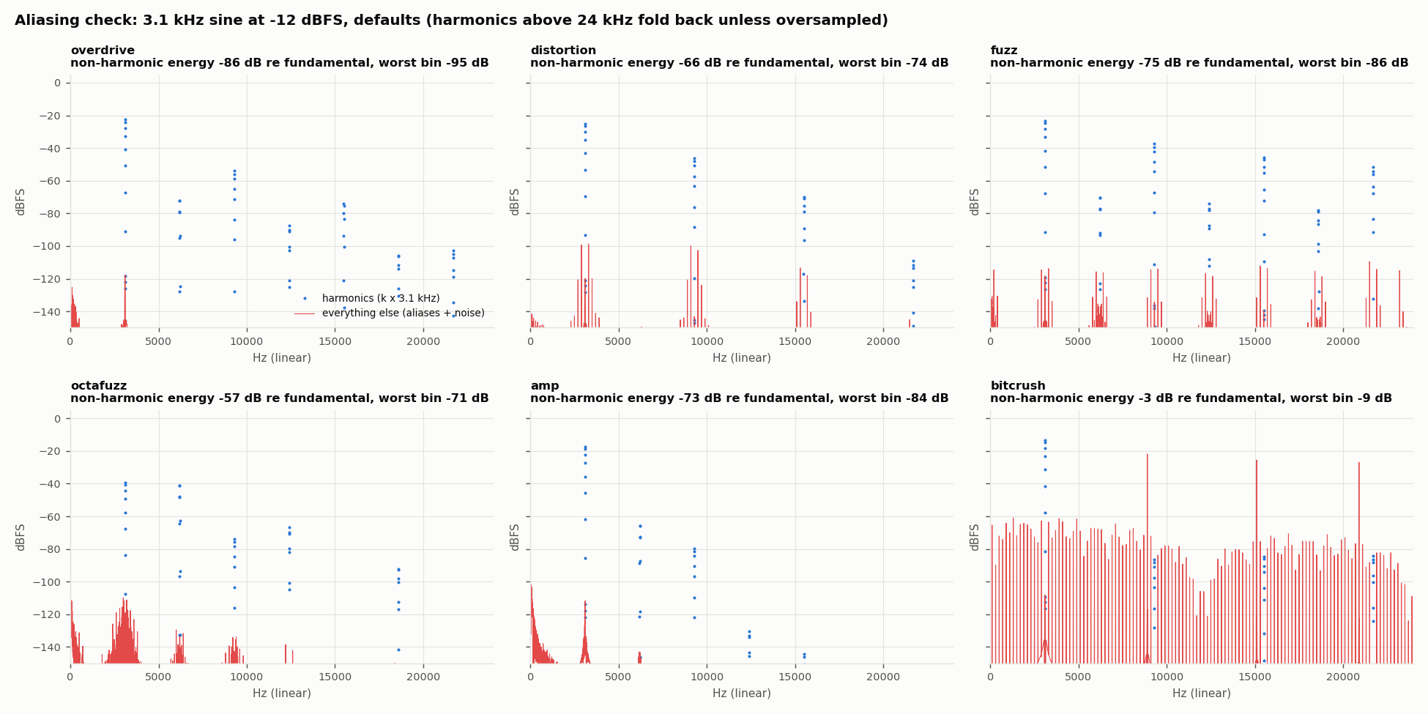
engine/tests/results/plots/drive_aliasing.png
