ryanmccormickdev/bassbox/engine/tests/results/plots/drive_shapers.png

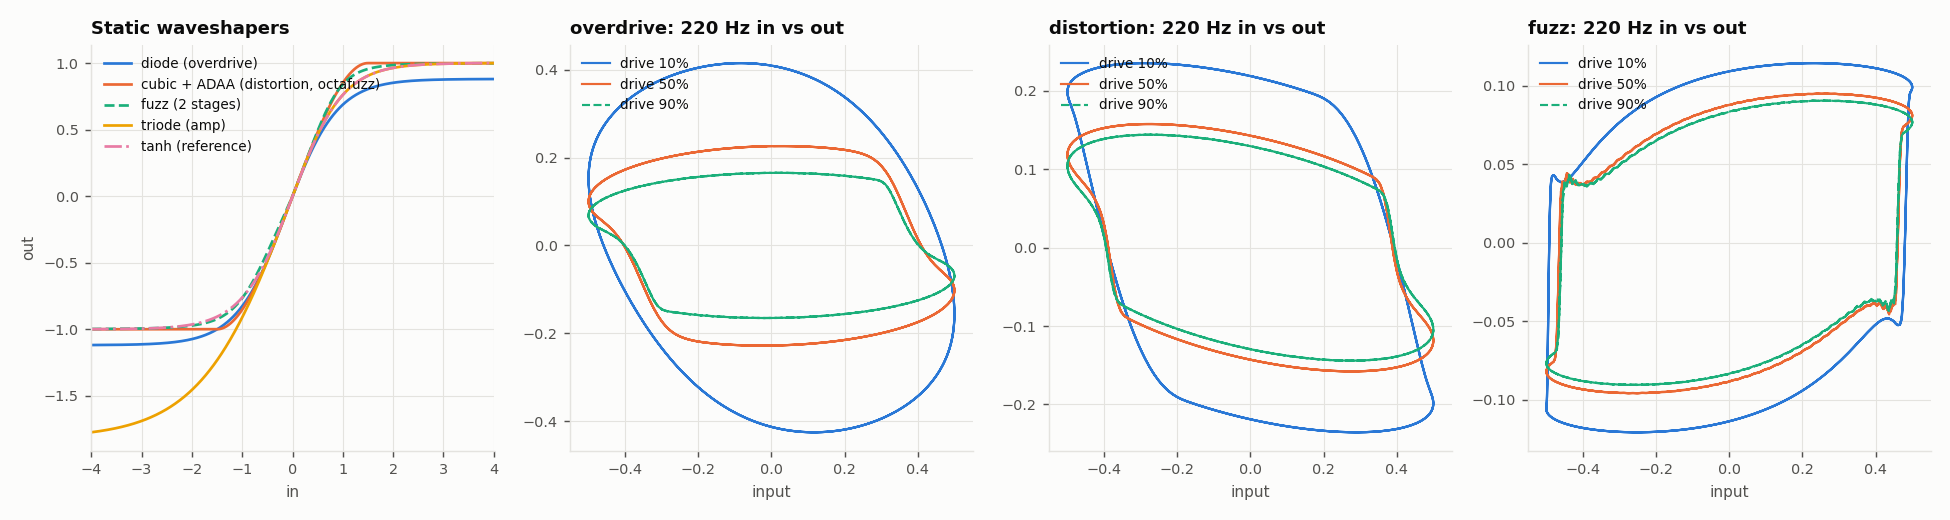
engine/tests/results/plots/drive_shapers.png
