ryanmccormickdev/bassbox/engine/tests/results/plots/eq_responses.png

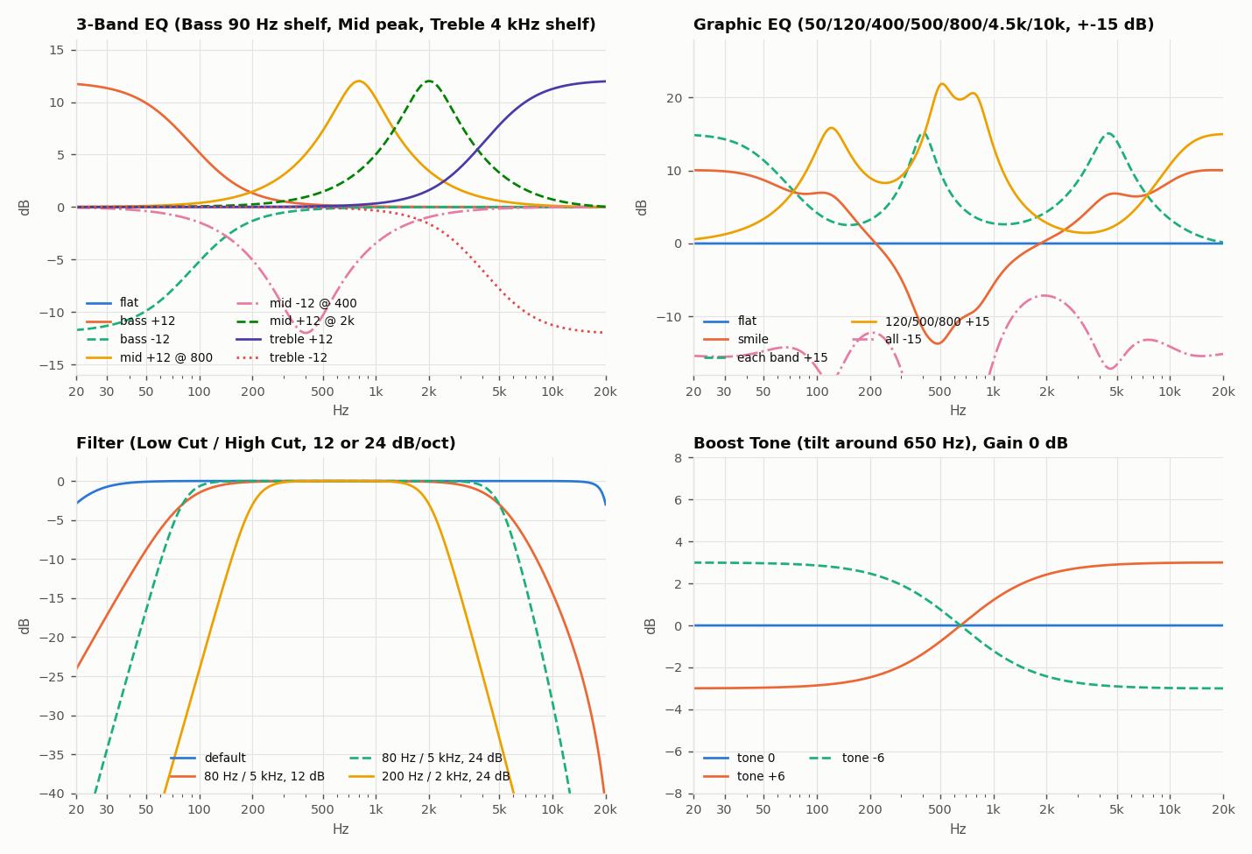
engine/tests/results/plots/eq_responses.png
