ryanmccormickdev/bassbox/engine/tests/results/plots/modulation_lowcut.png

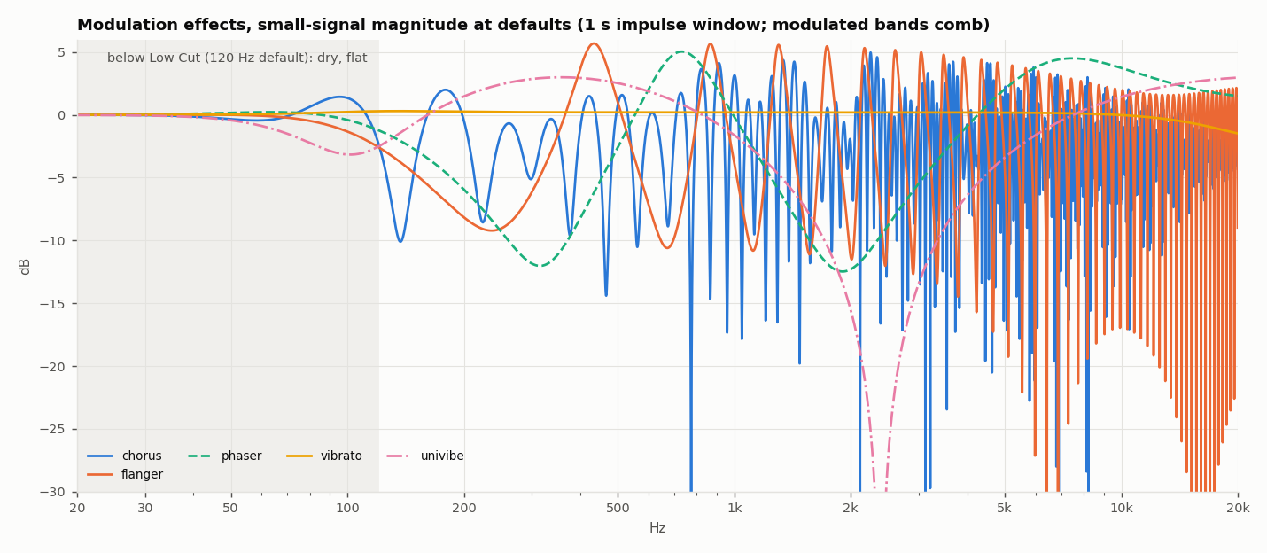
engine/tests/results/plots/modulation_lowcut.png
