ryanmccormickdev/bassbox/engine/tests/results/plots/time_decay.png

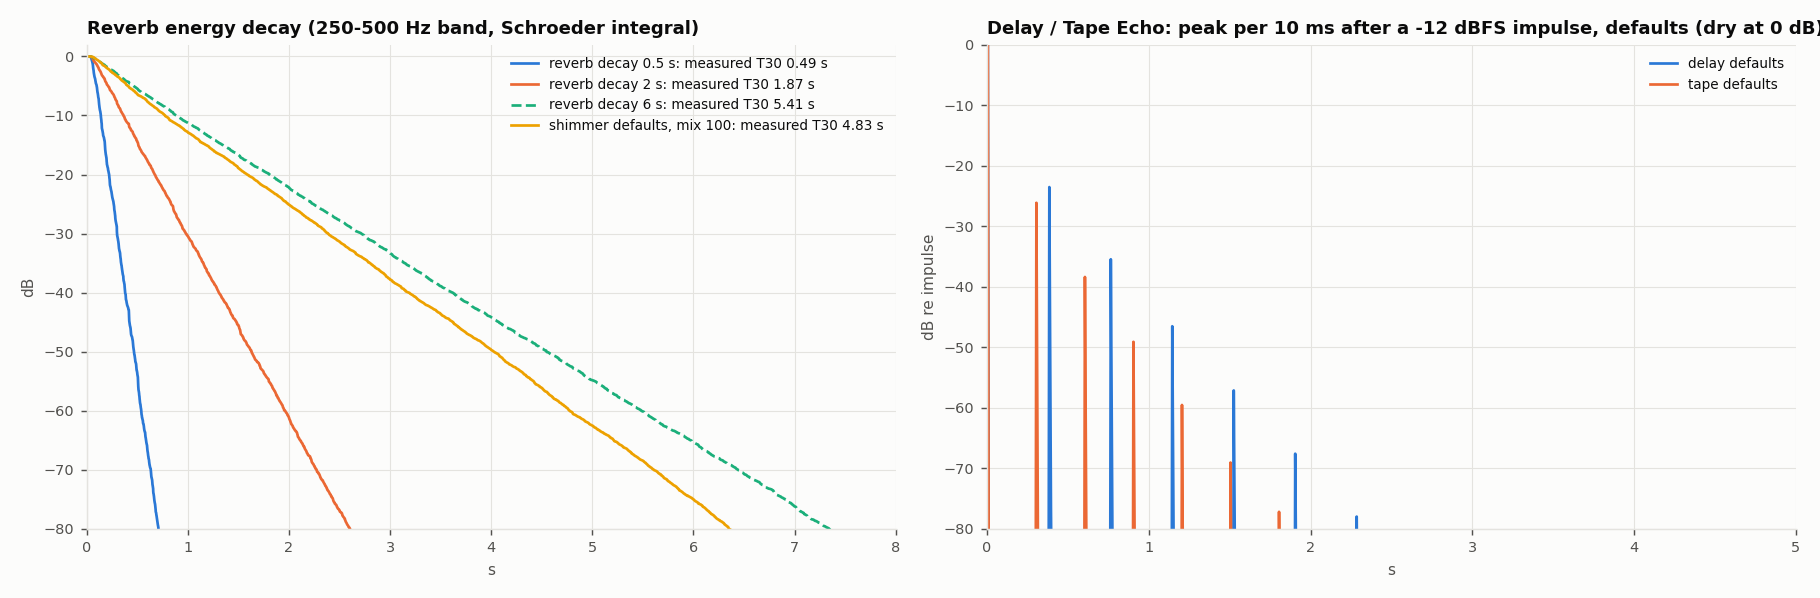
engine/tests/results/plots/time_decay.png
