ryanmccormickdev/bassbox/enclosure/print-profiles/prusa-mk39s/prusa-mk39s-clear-petg-0.15.ini

arc_fitting = emit_center
avoid_crossing_perimeters = 1
bed_shape = 0x0,250x0,250x210,0x210
bed_temperature = 80
before_layer_gcode = ;BEFORE_LAYER_CHANGE\nG92 E0.0\n;[layer_z]\nM201 X{interpolate_table(extruded_weight_total, (0,4000), (1400,2500), (20000,2500))} Y{interpolate_table(extruded_weight_total, (0,4000), (1400,2500), (20000,2500))}\n
between_objects_gcode = 
binary_gcode = 0
bottom_fill_pattern = monotonic
bottom_solid_layers = 7
bottom_solid_min_thickness = 0.5
bridge_acceleration = 1500
bridge_fan_speed = 60
bridge_flow_ratio = 1
bridge_speed = 45
brim_separation = 0.1
color_change_gcode = M600\nG1 E0.3 F1500 ; prime after color change
cooling = 1
cooling_perimeter_transition_distance = 10
cooling_slowdown_logic = consistent_surface
default_acceleration = 2500
deretract_speed = 25
disable_fan_first_layers = 3
dont_support_bridges = 0
elefant_foot_compensation = 0.2
enable_dynamic_fan_speeds = 1
enable_dynamic_overhang_speeds = 1
end_filament_gcode = "; Filament-specific end gcode"
end_gcode = {if layer_z < max_print_height}G1 Z{z_offset+min(max_layer_z+1, max_print_height)} F720 ; Move print head up{endif}\nM104 S0 ; turn off temperature\nM140 S0 ; turn off heatbed\nM107 ; turn off fan\nG1 X241 Y170 F3600 ; park\n{if layer_z < max_print_height}G1 Z{z_offset+min(max_layer_z+23, max_print_height)} F300 ; Move print head up{endif}\nG4 ; wait\nM572 S0 ; reset PA\nM593 X T2 F0 ; disable IS\nM593 Y T2 F0 ; disable IS\nM84 X Y E ; disable motors\n; max_layer_z = [max_layer_z]
external_perimeter_acceleration = 1500
external_perimeter_extrusion_width = 0.45
external_perimeter_speed = 30
external_perimeters_first = 0
extra_perimeters = 0
extruder_clearance_height = 13
extruder_clearance_radius = 45
extruder_offset = 0x0
extrusion_multiplier = 1
extrusion_width = 0.45
fan_always_on = 1
fan_below_layer_time = 20
filament_colour = #FF8000
filament_cooling_final_speed = 2.5
filament_cooling_initial_speed = 5
filament_cooling_moves = 3
filament_cost = 27.82
filament_density = 1.27
filament_diameter = 1.75
filament_infill_max_crossing_speed = 110
filament_infill_max_speed = 0
filament_load_time = 10.5
filament_loading_speed = 10
filament_loading_speed_start = 50
filament_max_volumetric_speed = 12
filament_minimal_purge_on_wipe_tower = 35
filament_notes = ""
filament_ramming_parameters = "250 100 42.4194 42.4194 42.4194 42.4194 42.4194| 0.05 42.4387 0.45 42.4387 0.95 42.4387 1.45 42.4387 1.95 42.4387 2.45 42.4387 2.95 42.4387 3.45 42.4387 3.95 42.4387 4.45 42.4387 4.95 42.4387"
filament_retract_before_wipe = 20
filament_retract_length = 0.8
filament_retract_lift = 0.15
filament_settings_id = "Generic PETG @MK4S"
filament_soluble = 0
filament_stamping_distance = 45
filament_stamping_loading_speed = 26.5
filament_toolchange_delay = 0
filament_travel_max_lift = 1.5
filament_travel_ramping_lift = 1
filament_travel_slope = 1
filament_type = PETG
filament_unload_time = 8.5
filament_unloading_speed = 60
filament_unloading_speed_start = 60
filament_vendor = Generic
filament_wipe = 1
fill_angle = 45
fill_density = 100%
fill_pattern = rectilinear
first_layer_acceleration = 500
first_layer_acceleration_over_raft = 0
first_layer_bed_temperature = 85
first_layer_extrusion_width = 0.5
first_layer_height = 0.2
first_layer_infill_speed = 100
first_layer_speed = 20
first_layer_speed_over_raft = 30
first_layer_temperature = 240
full_fan_speed_layer = 5
gap_fill_enabled = 1
gap_fill_speed = 60
gcode_comments = 0
gcode_flavor = marlin2
gcode_label_objects = firmware
gcode_resolution = 0.008
high_current_on_filament_swap = 0
idle_temperature = 70
infill_acceleration = 4000
infill_anchor = 2
infill_anchor_max = 12
infill_every_layers = 1
infill_extruder = 1
infill_extrusion_width = 0.45
infill_first = 0
infill_overlap = 15%
infill_speed = 110
interface_shells = 0
ironing_type = top
layer_gcode = ;AFTER_LAYER_CHANGE\n;[layer_z]\n{if ! spiral_vase}M74 W[extruded_weight_total]{endif}\n
layer_height = 0.15
machine_limits_usage = emit_to_gcode
machine_max_acceleration_e = 2500,2500
machine_max_acceleration_extruding = 4000,2500
machine_max_acceleration_retracting = 2500,2500
machine_max_acceleration_travel = 4000,2500
machine_max_acceleration_x = 4000,2500
machine_max_acceleration_y = 4000,2500
machine_max_acceleration_z = 200,200
machine_max_feedrate_e = 100,100
machine_max_feedrate_x = 300,160
machine_max_feedrate_y = 300,160
machine_max_feedrate_z = 40,40
machine_max_jerk_e = 10,10
machine_max_jerk_x = 8,8
machine_max_jerk_y = 8,8
machine_max_jerk_z = 2,2
machine_max_junction_deviation = 0.01,0.01
machine_min_extruding_rate = 0,0
machine_min_travel_rate = 0,0
max_fan_speed = 40
max_layer_height = 0.30
max_print_height = 220
max_print_speed = 200
max_volumetric_extrusion_rate_slope_negative = 0
max_volumetric_extrusion_rate_slope_positive = 0
max_volumetric_speed = 0
min_bead_width = 85%
min_fan_speed = 20
min_feature_size = 25%
min_layer_height = 0.07
min_print_speed = 15
min_skirt_length = 4
mmu_segmented_region_max_width = 0
nozzle_diameter = 0.4
nozzle_high_flow = 0
octoprint_apikey = 
octoprint_host = 
only_retract_when_crossing_perimeters = 0
ooze_prevention = 0
output_filename_format = {input_filename_base}_0.4n_{layer_height}mm_{printing_filament_types}_{printer_model}_{print_time}.gcode
over_bridge_speed = 50%
overhang_fan_speed_0 = 40
overhang_speed_0 = 15
overhang_speed_1 = 25
overhang_speed_2 = 45
overhang_speed_3 = 90%
overhangs = 1
perimeter_acceleration = 2500
perimeter_extruder = 1
perimeter_extrusion_width = 0.45
perimeter_generator = arachne
perimeter_speed = 60
perimeters = 5
print_settings_id = 0.15mm STRUCTURAL @MK4S 0.4
printer_model = MK3.9S
printer_notes = Don't remove the following keywords! These keywords are used in the "compatible printer" condition of the print and filament profiles to link the particular print and filament profiles to this printer profile.\nPRINTER_MODEL_MK4S\nPG\nNO_TEMPLATES
printer_settings_id = Original Prusa MK3.9S 0.4 nozzle
printer_technology = FFF
printer_variant = 0.4
raft_contact_distance = 0.15
raft_expansion = 1.5
raft_first_layer_density = 90%
raft_first_layer_expansion = 3
remaining_times = 1
retract_before_travel = 1.5
retract_before_wipe = 80
retract_layer_change = 1
retract_length = 0.7
retract_length_toolchange = 0
retract_lift = 0.2
retract_lift_above = 0
retract_lift_below = 219
retract_restart_extra = 0
retract_restart_extra_toolchange = 0
retract_speed = 35
seam_position = aligned
serial_port = 
serial_speed = 250000
silent_mode = 1
single_extruder_multi_material = 0
single_extruder_multi_material_priming = 0
skirts = 0
slice_closing_radius = 0.049
slowdown_below_layer_time = 7
small_perimeter_speed = 25
solid_fill_pattern = monotonic
solid_infill_acceleration = 3000
solid_infill_below_area = 0
solid_infill_every_layers = 0
solid_infill_extruder = 1
solid_infill_extrusion_width = 0.45
solid_infill_speed = 140
start_filament_gcode = "{if printer_notes!~/.*(MK4IS|XLIS|MK4S|MK3.9S|COREONE).*/}\nM900 K{if nozzle_diameter[filament_extruder_id]==0.4}0.07{elsif nozzle_diameter[filament_extruder_id]==0.25}0.12{elsif nozzle_diameter[filament_extruder_id]==0.3}0.09{elsif nozzle_diameter[filament_extruder_id]==0.35}0.08{elsif nozzle_diameter[filament_extruder_id]==0.6}0.04{elsif nozzle_diameter[filament_extruder_id]==0.5}0.05{elsif nozzle_diameter[filament_extruder_id]==0.8}0.02{else}0{endif} ; Legacy LA\n{else}\nM572 S{if nozzle_diameter[filament_extruder_id]==0.4}0.053{elsif nozzle_diameter[filament_extruder_id]==0.5}0.042{elsif nozzle_diameter[filament_extruder_id]==0.6}0.032{elsif nozzle_diameter[filament_extruder_id]==0.8}0.018{elsif nozzle_diameter[filament_extruder_id]==0.25}0.18{elsif nozzle_diameter[filament_extruder_id]==0.3}0.1{else}0{endif} ; Pressure advance\n{endif}\n\nM142 S36 ; set heatbreak target temp"
start_gcode = M17 ; enable steppers\nM862.1 P[nozzle_diameter] A{(filament_abrasive[0] ? 1 : 0)} F{(nozzle_high_flow[0] ? 1 : 0)} ; nozzle check\nM862.3 P "[printer_model]" ; printer model check\nM862.5 P2 ; g-code level check\nM862.6 P"Input shaper" ; FW feature check\nM115 U6.5.3+12780\n\nM555 X{(min(print_bed_max[0], first_layer_print_min[0] + 32) - 32)} Y{(max(0, first_layer_print_min[1]) - 4)} W{((min(print_bed_max[0], max(first_layer_print_min[0] + 32, first_layer_print_max[0])))) - ((min(print_bed_max[0], first_layer_print_min[0] + 32) - 32))} H{((first_layer_print_max[1])) - ((max(0, first_layer_print_min[1]) - 4))}\n\nG90 ; use absolute coordinates\nM83 ; extruder relative mode\n\nM140 S[first_layer_bed_temperature] ; set bed temp\nM104 T0 S{((filament_notes[0]=~/.*MBL160.*/) ? 160 : (filament_notes[0]=~/.*HT_MBL10.*/) ? (first_layer_temperature[0] - 10) : (filament_type[0] == "PC" or filament_type[0] == "PA") ? (first_layer_temperature[0] - 25) : (filament_type[0] == "FLEX") ? 210 : (filament_type[0]=~/.*PET.*/) ? 175 : 170)} ; set extruder temp for bed leveling\nM109 T0 R{((filament_notes[0]=~/.*MBL160.*/) ? 160 : (filament_notes[0]=~/.*HT_MBL10.*/) ? (first_layer_temperature[0] - 10) : (filament_type[0] == "PC" or filament_type[0] == "PA") ? (first_layer_temperature[0] - 25) : (filament_type[0] == "FLEX") ? 210 : (filament_type[0]=~/.*PET.*/) ? 175 : 170)} ; wait for temp\n\nM84 E ; turn off E motor\n\nG28 ; home all without mesh bed level\n\nG1 X42 Y-4 Z5 F4800\n\nM302 S155 ; lower cold extrusion limit to 155C\n\n{if filament_type[initial_tool]=="FLEX"}\nG1 E-4 F2400 ; retraction\n{else}\nG1 E-2 F2400 ; retraction\n{endif}\n\nM84 E ; turn off E motor\n\nG29 P9 X10 Y-4 W32 H4\n\n{if first_layer_bed_temperature[initial_tool]<=60}M106 S100{endif}\n\nG0 Z40 F10000\n\nM190 S[first_layer_bed_temperature] ; wait for bed temp\n\nM107\n\n;\n; MBL\n;\nM84 E ; turn off E motor\nG29 P1 ; invalidate mbl & probe print area\nG29 P1 X0 Y0 W50 H20 C ; probe near purge place\nG29 P3.2 ; interpolate mbl probes\nG29 P3.13 ; extrapolate mbl outside probe area\nG29 A ; activate mbl\n\n; prepare for purge\nM104 S{first_layer_temperature[0]}\nG0 X0 Y-4 Z15 F4800 ; move away and ready for the purge\nM109 S{first_layer_temperature[0]}\n\nG92 E0\nM569 S0 E ; set spreadcycle mode for extruder\n\n;\n; Extrude purge line\n;\nG92 E0 ; reset extruder position\nG1 E{(filament_type[0] == "FLEX" ? 4 : 2)} F2400 ; deretraction after the initial one before nozzle cleaning\nG0 E7 X15 Z0.2 F500 ; purge\nG0 X25 E4 F500 ; purge\nG0 X35 E4 F650 ; purge\nG0 X45 E4 F800 ; purge\nG0 X48 Z0.05 F8000 ; wipe, move close to the bed\nG0 X51 Z0.2 F8000 ; wipe, move quickly away from the bed\n\nG92 E0\nM221 S100 ; set flow to 100%
support_material = 0
support_material_angle = 0
support_material_auto = 0
support_material_bottom_contact_distance = 0
support_material_bottom_interface_layers = 0
support_material_buildplate_only = 0
support_material_closing_radius = 2
support_material_contact_distance = 0.17
support_material_enforce_layers = 0
support_material_extruder = 0
support_material_extrusion_width = 0.4
support_material_interface_contact_loops = 0
support_material_interface_extruder = 0
support_material_interface_layers = 3
support_material_interface_pattern = auto
support_material_interface_spacing = 0.2
support_material_interface_speed = 50
support_material_pattern = rectilinear
support_material_spacing = 2
support_material_speed = 120
support_material_style = snug
support_material_synchronize_layers = 0
support_material_threshold = 40
support_material_with_sheath = 0
support_material_xy_spacing = 80%
support_tree_angle = 40
support_tree_angle_slow = 25
support_tree_branch_diameter = 2
support_tree_branch_diameter_angle = 5
support_tree_branch_diameter_double_wall = 8
support_tree_branch_distance = 1
support_tree_tip_diameter = 0.8
support_tree_top_rate = 30%
temperature = 245
thick_bridges = 0
thin_walls = 0
thumbnails = 16x16/QOI, 313x173/QOI, 480x240/QOI, 380x285/PNG
toolchange_gcode = 
top_fill_pattern = monotonic
top_infill_extrusion_width = 0.42
top_solid_infill_acceleration = 1200
top_solid_infill_speed = 80
top_solid_layers = 7
top_solid_min_thickness = 0.7
travel_acceleration = 4000
travel_max_lift = 1.5
travel_ramping_lift = 1
travel_short_distance_acceleration = 250
travel_slope = 1
travel_speed = 300
travel_speed_z = 12
use_firmware_retraction = 0
use_relative_e_distances = 1
use_volumetric_e = 0
variable_layer_height = 1
wipe = 0
wipe_tower = 1
wipe_tower_cone_angle = 25
wipe_tower_extra_flow = 250%
wipe_tower_extra_spacing = 110%
z_offset = 0
